ZZ8874-001/BMC_CMZY_080/DOCS/BQ_ADC_ANOMALY_INVESTIGATION_2026-11-09.md

# BQ76920 电压异常读数调查（2026-11-09）

> **历史调查（已被 2026-11-10 降级方案取代）**：当前固件不再尝试恢复/信任真实 VC5/BAT；cell3 取 cell1/cell2 均值、pack 取三节和，raw VC5/VC3/VC4/BAT 仅作诊断。本文的 partial/降级归档/9 帧/锁存建议不再适用，仅保留为故障现象记录。

范围：只调查 `dbglog/` 中 2026-11-08/09 的 Ozone 导出、当前固件读数链路和 `DOCS/bq769X0.pdf`；未改固件，未做上板测量。**用户已确认焊接正常**；下文不把接线错误当成既定原因。所有 CSV 是 Ozone `Level,Expression,Value,Location,Refresh` **单次监视变量快照，不是逐帧时间序列**；同一快照内 1 Hz/5 Hz 轮询的变量也不一定同时采集。文件名中的操作描述不是独立测量证据。

## 可确认的现象

| 导出文件 | 当时记录 | 能确认什么 |
| --- | --- | --- |
| `Ozone_Watched_Data_1_261108复位后.csv` | `now_ms=1921`，`raw_vc3=5264`、`raw_vc4=6867`、`raw_pack=11691`，`last_reject_pack_mv=17802`；`frame_ok_count=0`、`reject_cell_count=5`，`sys_stat=0x8C`；配置及 ADC-off 回读正常，`xready_count=0`（行 30–33、60–82、88–103、118–142）。 | 开机后的异常不是单纯“未等到第一帧”：已有多次**完整帧**被电压范围校验拒绝。VC3/VC4 是 3S 应短接的未用差分通道，原始码本应接近零。 |
| `Ozone_Watched_Data_1_261108第一次重试后第二次重试前.csv` | 与上条同 `uptime_base_s=31632555`、LP seq=41；`now_ms=3570`，`raw_vc3=995`、`raw_vc4=1355`，`last_reject_pack_mv=12571`；`adc_restart_count=1`、`frame_ok_count=0`、`reject_sum_count=4`（行 30–33、73–103、132–149、268）。 | 同基准/seq、递增的启动毫秒数**支持**这是同次启动的后一张快照；仍非连续记录，不能完全排除中间又复位。两张快照间异常幅度减小，但尚未成功发布，不足以证明 ADC 重启是根因或最终恢复手段。 |
| `Ozone_Watched_Data_1_261108红灯快闪OK不涨.csv` | `now_ms=40031`，`raw_vc3=1589`、`raw_vc4=3018`，最近被拒 BAT 为 14833 mV；79 次拒绝（77 次 CELL_RANGE），`oor_streak=66`，两次重启额度用完、`adc_recovery_failed=1`，`last_update_ms=1299`（行 30–33、58–103、113–143）。 | 该回合异常**持续数十秒**且曾有少数好帧；不能只用 250–300 ms 的首次 ADC 建立时间解释。`HAL_I2C` 此刻 `State=READY,ErrorCode=0`（行 13–16），但它不是累计总线错误计数。 |
| `Ozone_Watched_Data_1_261108_红灯时ok帧增长阶段.csv` → `...红灯时ok帧增长阶段后状态正常.csv` | 两次快照共享 `uptime_base_s=31632453`、LP seq=18，`now_ms=52754→79990`，`frame_ok_count=97→151`、拒绝数始终 14；VC3/VC4 `0/7→7/8`，`fresh=1`（各文件行 30–33、58–89、149、204）。 | **同一回合**此时已经持续正常发布。它们与上条红灯/OK 不涨快照的 `uptime_base_s=31632461`、LP seq=23 不同，不能拼成“那次坏读数在未复位情况下恢复”的直接证据。 |
| `Ozone_Watched_Data_1_261109.csv` | 三节原始码 `9881/9881/9937`，VC3/VC4 `224/9`，BAT 原始码 `7483`；最近被拒三节 `3777/3777/3798` mV、BAT `11440` mV，原因 `VC34_SANITY`，`reject_vc34_count=3`（行 57–97）。 | 细小但可复现的未用通道异常会使一帧不发布，**即使三节电压约 3.8 V 且总压看起来合理**。该导出包含较新的结构体字段，不能据此认定其固件与 11/08 所有导出完全相同。 |

`Ozone_Watched_Data_1_261108复位完外加两次尝试失败后闪红灯前这次闪红灯后ok开始涨.csv` 的 `Value` 列全为空，**不能**用文件名验证“失败后自动恢复”。其余 `261108` 导出也不是同一程序版本/启动的连续曲线；对比前应核对 MCU `uptime_base_s`、LP session seq、固件镜像和 `now_ms`。

### 关键数值关系

在 11/09 快照中，当前读数的 `(9881+9881+9937+224+9)/4 = 7483`，**正好等于该次快照的 BAT 原始码**。另以**最近一次被拒帧**的 `last_reject_*` 比较：BAT 与三节之和相差 `11440−(3777+3777+3798)=88 mV`，同帧 VC3+VC4 的 `233` 个原始码乘 `(365+13) µV/码` 约为 `88.1 mV`。11/08 `Ozone_Watched_Data_1_261108.csv` 的最近被拒帧还显示约 `69 mV` 的 BAT−三节差（行 88–96），与 VC3 原始码 184 对应的约 `70 mV` 相近。TI 数据手册 §8.3.1.1.6（印刷页 21）说明 BAT 来自单节测量值之和除以四；这些数字支持异常 VC3/VC4 报告值与 BAT 偏高有关，但由于快照采集时序和跨寄存器更新边界，不能把它当作每一帧都严格满足的恒等式。当前固件仅把 VC1、VC2、VC5 当作三节（`App/bsp/bq_ic.c:123-134,483-516,959-985`）。

**结论强度：**观测强烈支持“BQ 报出的未用 VC3/VC4 差分码异常，并影响 BAT；校验层据此拒绝帧”。它**不能**单独判明异常发生在 IC 引脚实际差分电位、芯片模拟前端/采样时序，还是寄存器读取路径。数伏级坏帧还伴有 CELL_RANGE，不能声称仅靠 VC3/VC4 就解释了全部异常；部分 11/08 导出未展开三节被拒数组，无法对其做同一帧的完整总和校验。

## 固件行为与候选机制（按现有证据排序）

1. **优先排查 BQ 差分输入/芯片内部采样在启动及运行中的异常。** TI `DOCS/bq769X0.pdf` Table 9-2（印刷页 39）要求 3S 为 VC1−VC0、VC2−VC1、VC5−VC4，VC3−VC2 和 VC4−VC3 短接；`DOCS/PINMAP.md:157-174` 记载本板已做 3S 飞线。数字 VC3/VC4 很大与此不符，但不能仅凭 Ozone 码值否定已确认的焊接。TI §8.3.1.1.2（印刷页 17–18）说明单通道约 50 ms、整组约 250 ms，明确的“等待 250 ms”针对 **SHIP→NORMAL**；并未保证已在 NORMAL 的 `ADC_EN` 关开后 300 ms 必然稳定。反过来，持续约 40 s 的异常也不是普通的一个 250 ms 帧没等完。不能把 100 Ω ×100 nF 的常规滤波单独当成数秒/数伏现象的已证原因。决定性证据是异常**同时**测得 BQ 芯片脚 VC3−VC2、VC4−VC3 是否真有差分电压，并同步看 REGSRC、REGOUT、BAT、TS1。
2. **旧版恢复判决可能过早耗尽额度，但不制造原始坏码。** 11/08 对应提交中的 OOR 重采样/ADC-off 保持/verdict 分别为 `300/300/500 ms`；当前**未提交** `App/bsp/bq_ic.c:83-92` 为 `500/800/1500 ms`。首次有效发布还要两帧一致（`bq_ic.c:959-1090`），短 500 ms verdict 有机会先判失败并耗尽两次额度；旧日志中两次重启后仍数十秒有坏原始码，说明**只调大超时并不能证明消除物理/AFE 侧异常**。故障锁存后常规 RUN 读取仍继续；连续四个成功发布帧会清 `ADC_STUCK`/重启额度（`bq_ic.c:795-929`）。红灯可由保护锁存、自检状态等独立维持，不等于“ADC 此刻还没读到正常值”。
3. **I²C 边沿/CRC 及非原子采样是需要排除的次要因素。** 驱动分寄存器读 VC1/2/5、VC3/4 和 BAT，逐字节校验 CRC；通信失败走重试/回退路径，电压越界才走拒帧（`bq_ic.c:123-134,1480-1659,707-863`）。本板仅 MCU 内部上拉（`DOCS/PINMAP.md:47-49`），应测 SCL/SDA 上升沿和高电平时间；但 11/09 **同一快照的五通道/BAT 精确关系**不支持“随机 I²C 位翻转是唯一原因”。多次寄存器读取可跨 250 ms 芯片更新边界，须用同一 `last_reject_*` 帧而非不同时刻的 `raw_*`/已发布 `cell_mv` 硬算残差。`pack_residual_mv` 在拒帧时是上次**发布**帧的值。
4. **状态/告警是伴随现象，暂不宜定因。** 11/08 快照中有 OV/UV 锁存；11/09 的 `SYS_STAT=0x94` 含 CC_READY、OV、OVRD_ALERT，`xready_count=0`（`261109.csv:43,114-125`）。状态位不等于异常采样的触发原因。MCU 复位不一定让 BQ POR：`BQ_Init` 若仍能探测到芯片会跳过 TS1 唤醒脉冲（`bq_ic.c:1797-1818`）；比较 MCU 复位、LP 出入及真正上电后的症状，但不要凭 LED 颜色倒推 ADC 原因。

## 补充现场观察：故障时第三节显示「7 V 满值」

用户补充：**每次故障时第三节电池电压均显示为 7 V 满值**。这条现场观察比现有 CSV 的缺失字段更能缩小范围：应优先检查 **CELL3 对应的 VC5−VC4 差分通道及其读回过程**，而不能只把 VC3/VC4 的非零码当成主因。此前的数伏级坏帧记录未展开 `raw_cell[2]` 和 `last_reject_cell_mv[2]`；仅凭这些 CSV 不能独立验证“无一例外”或确认精确的满值码。11/09 导出中展开的第三节原始码为 9937，最近一次被拒帧的第三节为 3798 mV，**并非 7 V**（`dbglog/Ozone_Watched_Data_1_261109.csv:57-60,88-96`），所以也不能把该次小幅 VC3/VC4 异常直接等同于用户描述的“第三节满值”故障。应在下一次典型故障时将 `raw_cell[2]`、`last_reject_cell_mv[2]` 连同 `raw_vc3/raw_vc4/raw_pack` 展开，记录带单位的显示来源。

**「7 V」需要先辨明是哪个变量/界面的值。** TI 数据手册 §8.3.1.1.2（印刷页 17）给 14 位单节 ADC 的标称满量程约 6.275 V。当前驱动在 `App/bsp/bq_ic.c:48,626-631,483-495` 对 VC5 原始值掩码 `0x3FFF`，并按 `GAIN×raw+OFFSET` 换算；日志中的 `GAIN=(365+13) µV/码`、`OFFSET=42 mV` 对应理论可计算最大约 **6.235 V**（整数实现为 6234 mV）。**7.000 V 需原始码至少 18408，超过 14 位最大 16383**；即使用驱动可解析的最大增益 396 µV/码、最大正偏移 127 mV，计算结果也不超过 6614 mV。固件又在 `bq_ic.c:712-716` 拒绝超过 5 V 的单节值，因此 `s_bq.cell_mv[2]`（上次成功发布值）不应等于 7000 mV。如果观察到的是某个上位机/Ozone 自定义换算、其他变量、界面显示钳位或近似口述的“7 V”，须与 `s_bq.raw_cell[2]`、`last_reject_cell_mv[2]` 对齐再判断；**不能把 7.000 V 直接称为当前驱动读到的 BQ 精确满量程值**。

若坏帧的 `raw_cell[2]` 确实反复接近 `0x3FFF`、而同时间外接测量 VC5−VC4 仍在正常 3–4 V，则“第三节真实过压”与单纯 mV 换算错误都弱，需重点区分 BQ 内部该通道饱和/采样异常、VC5/VC4 引脚电位瞬态、读寄存器地址/数据关联错误。若 `raw_cell[2]` 不饱和，但外部显示恒为 7 V，先追查该显示项的来源和换算。**一个待验证的外部显示假设**：若显示端用 `BAT−CELL1−CELL2` 反推第三节，11/08 红灯快闪快照的最近被拒 BAT 为 14833 mV，而此前发布的电芯电压约 3.8–3.9 V/节，则混用这些值可得到约 7 V；但它们**不是同一坏帧**，不能拿这个算式证明现场显示来源，也不能据此判定 VC5 饱和。当前固件直接读取 VC5 作为第三节（`App/bsp/bq_ic.h:29-39`），不以 BAT 减前两节。下一次应记录显示项的实际变量/表达式，并用同一坏帧的 `last_reject_cell_mv[0..2]` 和 `last_reject_pack_mv` 核算。VC3/VC4 异常可能与 VC5−VC4 共因，**不能由一个次要通道症状推断 VC5 饱和的根因**。

## 不改固件的最小验证顺序

1. 固定**同一个固件镜像和同一次 MCU boot**，在 Ozone 展开 `s_bq.last_reject_cell_mv[0..2]`、`last_reject_pack_mv`、`last_reject_vc3_raw/vc4_raw`、`raw_cell[0..2]`、`raw_pack`、`adc_gain/offset`、`frame_ok_count/frame_reject_count/reject_*_count`、`adc_restart_*`、`pre/post/adc_off_ctrl*`、`sys_stat`、`s_app.uptime_base_s`、LP session seq；在出现异常到恢复期间连续导出/记录带主机时间戳的数据。不要把不同 boot 的导出串成一条曲线，也不要用调试器暂停后的时长当真实 ADC 建立时间。
2. 在不拆线/不解除保护的前提下，用合适的高阻差分探头**优先同步测 BQ IC 引脚 VC5−VC4（第三节）**，并记录其对应 `raw_cell[2]`/`last_reject_cell_mv[2]`；再测 VC3−VC2、VC4−VC3，与数字 VC3/VC4 码对应：第三节引脚正常而码饱和 → 优先查 IC 内部采样、供电/复位时序及读寄存器链路；引脚确实出现差分瞬态 → 排查滤波网络与供电耦合（**不等于焊接坏**）。同时看 BAT、REGSRC、REGOUT、TS1、ALERT，注意示波器接地不要短接电池节点。
3. 针对正常运行/复位/LP 唤醒分别比较 ADC 启动后的约 50、250、500、1000 ms 及**异常持续数十秒**时的同帧 VC1–VC5/BAT 和状态；若改为当前 500/800/1500 ms 版本后复现率变化，记录镜像与上电/MCU 复位条件，以区分“启动窗口过短”和“持续异常”。另测 SCL/SDA 实际波形，核对 TI §7.6（印刷页 14）的 100 kHz、`tHIGH≥4 µs` 要求。

调查结论暂定为**「第三节显示异常满值（现场观察），并伴随 BQ 报告的 VC3/VC4 差分通道读数异常（快照已证）；VC5 原始码是否饱和，以及芯片输入端实际电位与内部采样/读寄存器之间尚缺同步证据」**，不是已经确诊了某个软件或硬件元件。待上述同帧数据和芯片脚波形齐全后再收敛原因。
