ZZ8874-001/BMC_CMZY_080/DOCS/SCH_SCHEM_BTT_CTRL_081_2026-10-30.pdf

# CAN SWD_PORT

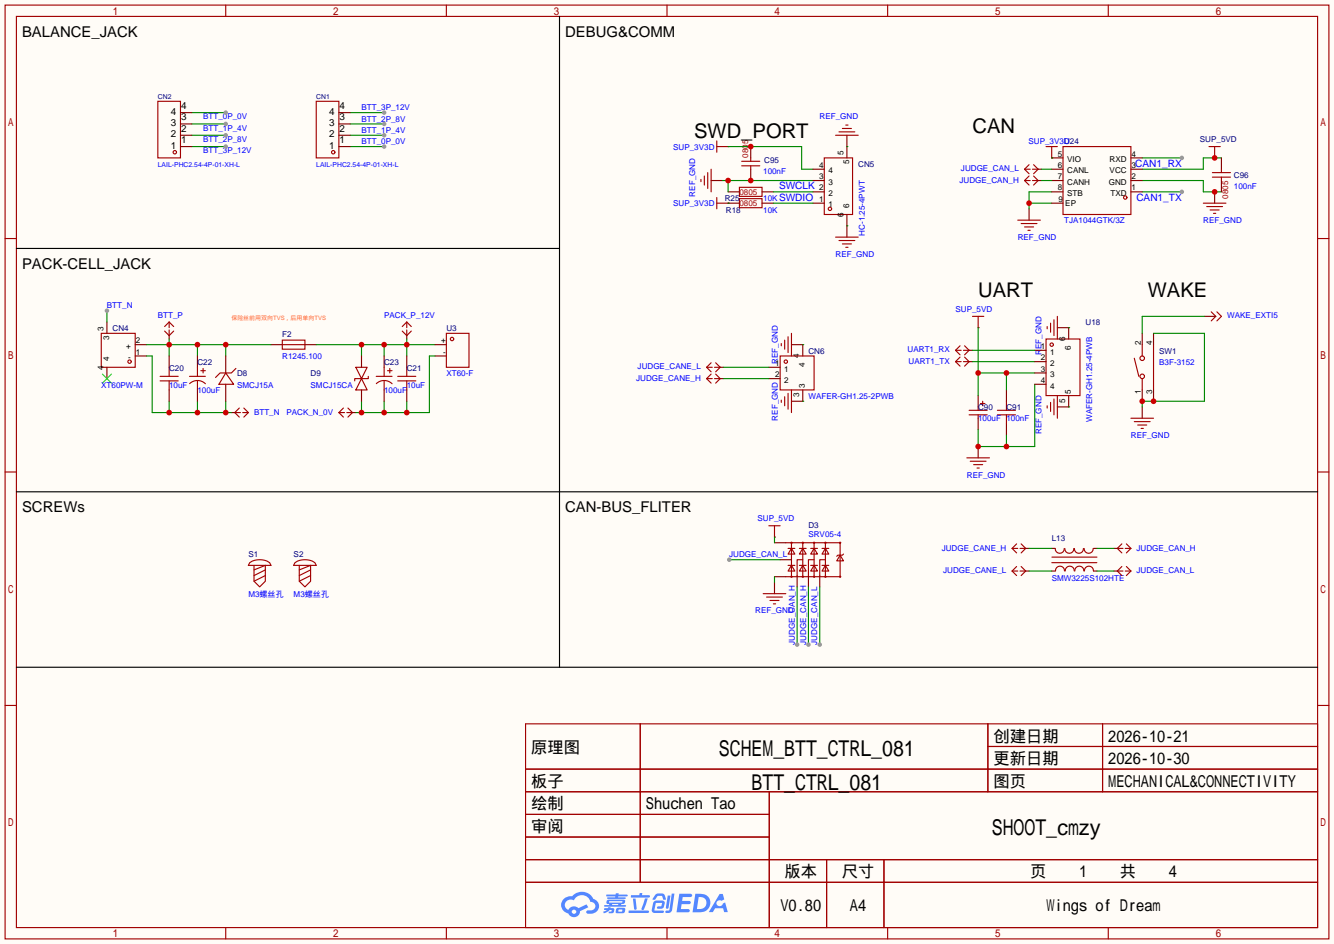
[picture p1: page 1]

原理图 | SCHEM_BTT_CTRL_081 | 创建日期 | 2026-10-21

更新日期 | 2026-10-30

板子 | BTT_CTRL_081 | 图页 | MECHANICAL&CONNECTIVITY
绘制 | Shuchen Tao | SHOOT_cmzy
审阅

V0.80 | A4 | Wings of Dream

# BMS

PWRSUP_RC | SC_TEMP&BOOT

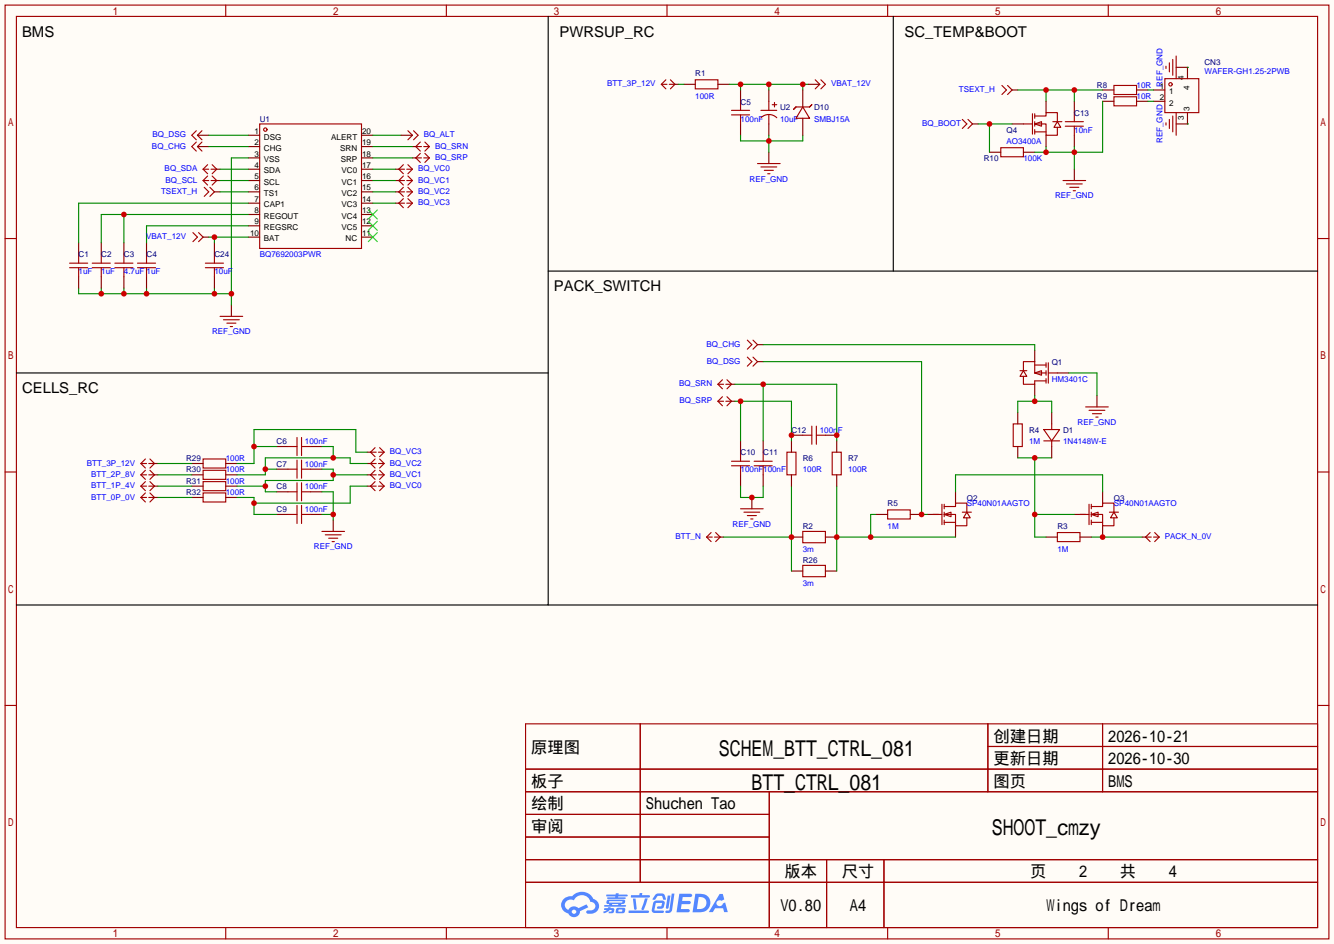
[picture p2: page 2]

原理图 | SCHEM_BTT_CTRL_081 | 创建日期 | 2026-10-21

更新日期 | 2026-10-30

板子 | BTT_CTRL_081 | 图页 | BMS
绘制 | Shuchen Tao | SHOOT_cmzy
审阅

PWR_5VD | PWR_LP3V3D | POTENTIAL

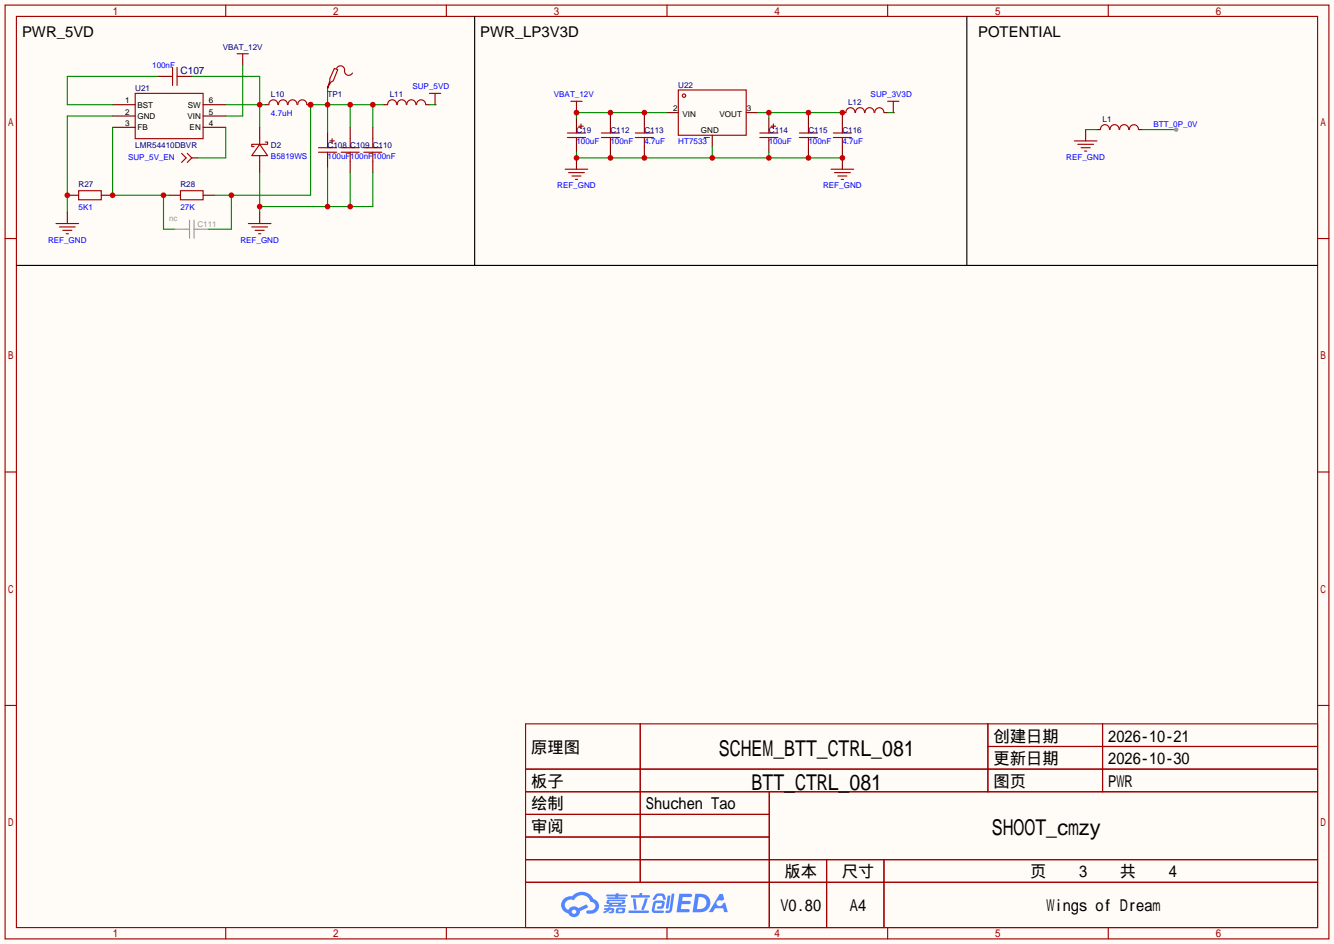
[picture p3: page 3]

原理图 | SCHEM_BTT_CTRL_081 | 创建日期 | 2026-10-21

更新日期 | 2026-10-30

板子 | BTT_CTRL_081 | 图页 | PWR
绘制 | Shuchen Tao | SHOOT_cmzy
审阅

# OSC1 12MHz REF_GND

MCU_MAIN | LEDs_IND

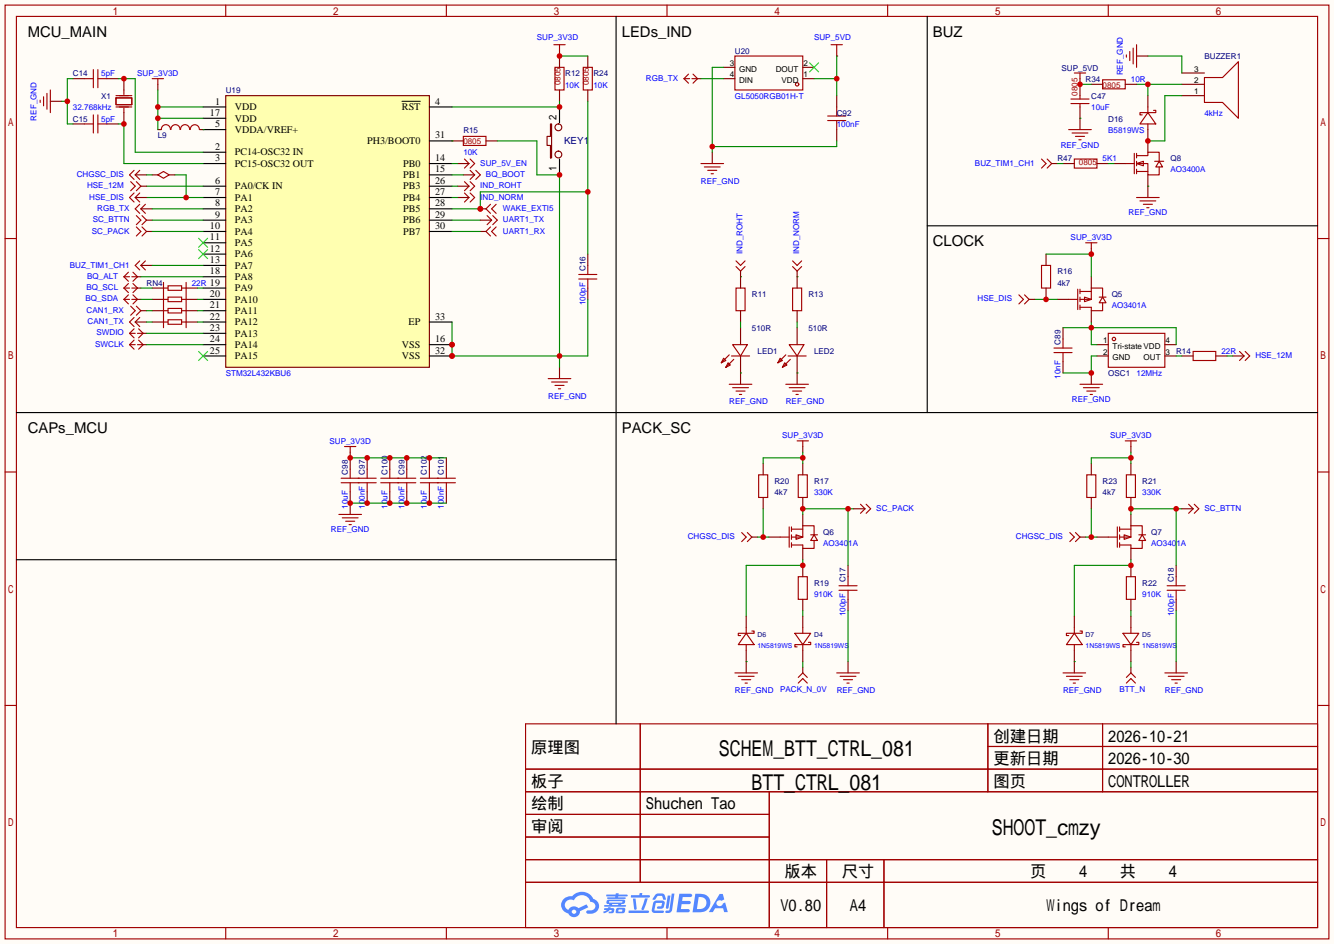
[picture p4: page 4]

原理图 | SCHEM_BTT_CTRL_081 | 创建日期 | 2026-10-21

更新日期 | 2026-10-30

板子 | BTT_CTRL_081 | 图页 | CONTROLLER
绘制 | Shuchen Tao | SHOOT_cmzy
审阅
