ZZ8874-001/BMC_CMZY_080/BMC_CMZY_080.ioc

Mcu.UserName=STM32L432KBUx
PA0.Signal=RCC_CK_IN
PA1.GPIO_Label=HSE_DIS
PA1.Signal=GPIO_Output
PA10.GPIO_Label=BQ_IIC1_SDA
PA10.Signal=I2C1_SDA
PA11.Signal=CAN1_RX
PA12.Signal=CAN1_TX
PA2.GPIO_Label=RGB_USART2_TX
PA2.Signal=USART2_TX
PA3.GPIO_Label=COMP_BTTN
PA3.Signal=COMP2_INP
PA4.GPIO_Label=COMP_PACK
PA4.Signal=COMP2_INM
PA7.GPIO_Label=BUZ_TIM1_CH1
PA7.Signal=TIM1_CH1N
PA8.GPIO_Label=BQ_ALT_EXTI8
PA8.Signal=GPXTI8
PA9.GPIO_Label=BQ_IIC1_SCL
PA9.Signal=I2C1_SCL
PB0.GPIO_Label=SUP_5V_EN
PB0.Signal=GPIO_Output
PB1.GPIO_Label=BQ_BOOT
PB1.Signal=GPIO_Output
PB5.GPIO_Label=WAKE_EXTI5
PB5.Signal=GPIO_Input
PB6.Signal=USART1_TX
PB7.Signal=USART1_RX
