ZZ8874-001/BMC_CMZY_080/Core/Src/main.c

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
/* Includes ------------------------------------------------------------------*/
#include "main.h"

/* USER CODE BEGIN Includes */
#include "app/main_app.h"
#include "app/watchdog.h"
/* USER CODE END Includes */

CAN_HandleTypeDef hcan1;

COMP_HandleTypeDef hcomp2;

DAC_HandleTypeDef hdac1;

I2C_HandleTypeDef hi2c1;
DMA_HandleTypeDef hdma_i2c1_rx;
DMA_HandleTypeDef hdma_i2c1_tx;

IWDG_HandleTypeDef hiwdg;

LPTIM_HandleTypeDef hlptim1;

RTC_HandleTypeDef hrtc;

TIM_HandleTypeDef htim1;
TIM_HandleTypeDef htim2;

UART_HandleTypeDef huart1;
UART_HandleTypeDef huart2;

void SystemClock_Config(void);
static void MX_GPIO_Init(void);
static void MX_DMA_Init(void);
static void MX_CAN1_Init(void);
static void MX_COMP2_Init(void);
static void MX_DAC1_Init(void);
static void MX_I2C1_Init(void);
static void MX_USART1_UART_Init(void);
static void MX_USART2_UART_Init(void);
static void MX_TIM1_Init(void);
static void MX_RTC_Init(void);
static void MX_TIM2_Init(void);
static void MX_LPTIM1_Init(void);
static void MX_IWDG_Init(void);
/**
  * @brief  The application entry point.
  * @retval int
  */
int main(void)
{

  /* MCU Configuration--------------------------------------------------------*/

  /* Reset of all peripherals, Initializes the Flash interface and the Systick. */
  HAL_Init();

  /* USER CODE BEGIN Init */
  /* Defensive legacy LSE-CSS cleanup.  Current IOC has EnableCSSLSE=false and
   * the firmware never enables it; an old build may have left LSECSSON/D set
   * in the backup domain.  Clear it before the RTC source helper runs so a
   * dead LSE cannot hold boot.  A BDRST here clears BKP (LP session) once. */
  __HAL_RCC_PWR_CLK_ENABLE();
  HAL_PWR_EnableBkUpAccess();
  if ((RCC->BDCR & (RCC_BDCR_LSECSSON | RCC_BDCR_LSECSSD)) != 0u)
  {
      SET_BIT(RCC->BDCR, RCC_BDCR_BDRST);
      CLEAR_BIT(RCC->BDCR, RCC_BDCR_BDRST);
  }
  /* USER CODE END Init */

  /* Configure the system clock */
  SystemClock_Config();

  /* USER CODE BEGIN SysInit */
  /* Keep LSE CSS off; the current IOC does not enable it.  LSERDY is only a
   * diagnostic in LP_RTC_USE_LSE=1 builds (PowerMode_LseHealthTask()). */
  CLEAR_BIT(RCC->BDCR, RCC_BDCR_LSECSSON);
  /* USER CODE END SysInit */

  /* Initialize all configured peripherals */
  MX_GPIO_Init();
  MX_DMA_Init();
  MX_CAN1_Init();
  MX_COMP2_Init();
  MX_DAC1_Init();
  MX_I2C1_Init();
  MX_USART1_UART_Init();
  MX_USART2_UART_Init();
  MX_TIM1_Init();
  MX_RTC_Init();
  MX_TIM2_Init();
  MX_LPTIM1_Init();
  MX_IWDG_Init();
  /* USER CODE BEGIN 2 */
  App_Boot();
  /* USER CODE END 2 */

  /* Infinite loop */
  /* USER CODE BEGIN WHILE */
  while (1)
  {
    /* USER CODE END WHILE */

    /* USER CODE BEGIN 3 */
    App_Loop();
  }
  /* USER CODE END 3 */
}

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
