ZZ8874-001/BMC_CMZY_080/App/detect/bms/bms_config.h

/*********************************************************************************
 * File Name          : bms_config.h
 * Description        : 电池 SOC / SOH 算法库 —— 唯一配置入口
 *
 * 算法库的全部可调参数都集中在本文件, 一共 10 组:
 *   [1] 电芯参数     换电芯只改这一组 (标称容量 + 容量可用范围 + 4 张标定表)
 *   [2] 调度与时基   主循环调用周期 / 时间戳跳变保护
 *   [3] 静置判据     静置电流门限 + 静置时长 (SOC 重同步 / SOH 锚点)
 *   [4] EKF 参数     一阶 RC 扩展卡尔曼: 过程噪声 / 量测噪声 / 初值
 *   [5] SOH 判据     R0 学习 (电流阶跃) + Q 学习 (OCV 锚点) + 卡尔曼融合
 *   [6] 钳位与防呆   容量范围 / R0 表存储范围 / SOH_R 统计网格
 *   [7] 移植开关     时间戳来源 / exp 来源
 *   [8] 掉电保持     学习结果存非易失介质 / 落盘去抖 / 介质选型
 *   [9] 在线调参     运行时通过串口改标定表与参数的协议层开关
 *   [10] 温度/倍率/循环 容量与 SOC 的工况折算 + 循环计数与累计充放电
 * 每组标题下都写了"什么时候需要改 / 改了会怎样"。
 * 文件末尾还有一节"编译期一致性自检": 整数类参数改冲突了会直接编译报错。
 *
 * ---------------------------------------------------------------------
 * 调参速查 (想改什么 -> 改哪个宏):
 *   换电芯 / 换容量 .......... SOC_CAPACITY_NOMINAL_MAH + 4 张表       [1]
 *   主循环周期变了 .......... BMS_UPDATE_PERIOD_MS                    [2]
 *   静置多久才重同步 ........ SOC_IDLE_MS                             [3]
 *   静置多久才学容量 ........ SOH_MIN_REST_MS                         [3]
 *   静置电流门限 ............ SOC_IDLE_CUR_MA / SOH_IDLE_MA           [3]
 *   显示抖动大 / 跟不紧 ..... BMS_EKF_R_V / BMS_EKF_Q_SOC             [4]
 *   学不到容量 (不触发) ..... SOH_Q_MIN_DSOC_01 / SOH_Q_MIN_DQ_MAH    [5]
 *   容量学得太猛 / 上跳 ..... SOH_Q_KF_RUP / SOH_Q_KF_Q               [5]
 *   R0 学不动 / 学太乱 ...... SOH_I_ON_MA / SOH_R0_ALPHA              [5]
 *   温度窗口太窄/太宽 ....... SOH_TEMP_LO_C / SOH_TEMP_HI_C           [5]
 *   容量被钳得不对 .......... SOC_CAP_LO_PCT / SOC_CAP_HI_PCT         [6]
 *   没有毫秒时基 ............ BMS_USE_TICK                            [7]
 *   不想链接 libm ........... BMS_USE_LIBM_EXPF                       [7]
 *   SOH 学到的东西掉电就丢 .. BMS_USE_NVM                             [8]
 *   落盘太勤 (磨 Flash) ..... BMS_NVM_DEBOUNCE_MS                     [8]
 *   想用串口改标定表 ........ BMS_USE_TUNE                            [9]
 *   调参缓冲太大 (省 RAM) ... BMS_TUNE_RX_MAX                         [9]
 *   低温/大倍率容量折算 ...... SOC_CAP_TEMP_PCT / SOC_PEUKERT_K       [10]
 *   循环计数阈值 ............ SOH_CYCLE_SWING_01 / SOH_COUNT_SAVE_PCT [10]
 *
 * 说明: 极少数参数 (0.01% 定点比例 10000 / 每 0.01% 的 mA·ms 换算系数
 * 360×容量 / 网格步长 10%) 属于算法定义而非可调量, 仍写在 soc.c / soh.c
 * 里; 改它们等于换算法, 不在本文件暴露。
 *
 * [5] 与 ../tools/soh_learn 顶部的常量一一对应, 改一处必须改两处!
 * (../tools/soh_mcu_sim 启动时会逐项比对并报警)
 *
 * 源码编码 UTF-8, 换行 LF。
 * 移植方法与调用顺序见同目录 README.md。
 *
 * 许可: MIT (见仓库根 LICENSE)。Copyright (c) 2026 锂电池 SOC/SOH 算法库 贡献者。
 *******************************************************************************/

#ifndef __BMS_CONFIG_H
#define __BMS_CONFIG_H

/* =====================================================================
 * [1] 电芯参数 —— 换电芯只改这一段
 * ===================================================================== */

/* 电芯标称容量 mAh。本板为 3S 三元锂（NMC）1500 mAh 电芯，单节容量填 1500；
 * 取标称值偏保守，使带载积分 SOC 略偏低不虚高。换电芯时按实际修改!
 *
 * 注意: 容量不是常量 —— soh.c 的在线学习会按实测改写运行时容量 s_cap_mah,
 * 本宏只是"上电初值 / 学习失败的兜底值 / SOH 的分母"。
 * 运行期一切积分与 EKF 都用 SOC_GetCapacityMAh() 取当前值。 */
#define SOC_CAPACITY_NOMINAL_MAH   1500

/* 容量可用范围 (占标称的百分比)。
 *
 * 运行时容量 (含学习结果) 被钳在这两个百分比之间, 挡单次离谱估计把 SOC
 * 算飞; 也顺带决定 SOH_Q 的下限 —— 容量学到 55% 标称, SOH_Q 就是 55%。
 *   下限 50  ->  0.50 倍标称 (低于此早已远超 EOL, 必是估计出错)
 *   上限 110 ->  1.10 倍标称 (新电芯实测略高于标称属正常散布)
 * 换到"标称值明显不准"的杂牌电芯时, 若实测容量落在范围外被钳住, 改这里。 */
#define SOC_CAP_LO_PCT             50
#define SOC_CAP_HI_PCT             110

/* =====================================================================
 * 温度维度
 *
 * 标定表不再是"一张", 而是"三个温度点各一张":
 *     BMS_CAL_TEMP_DC = { 5C, 25C, 45C }
 * 运行时按当前温度在相邻两点之间线性插值, 得到"当前温度的表"再用。
 * 温度低于最低点或高于最高点时端点平延 (不外推 —— 外推没有物理依据)。
 *
 * 注意: 本库随附的示例数据只有 25C 是实测的, 5C / 45C 直接复用 25C 的值
 *       占位 —— 三个点相同, 插值结果恒等于 25C 的值, 等价于"暂不随温度变"。
 *       换电芯后请把另外两个温度点补齐: 直接改下面的宏,
 *       或在运行时用 BMS_CAL_SetPoint() 写入 (见 README 多温度标定章节)。
 *
 * 插值只做线性: 三个点撑不起二次, 线性 + 端点平延是这种稀疏标定的
 * 合理选择 (Arrhenius 型关系在 5~45C 区间接近线性)。
 * ===================================================================== */

/* 温度点个数。改点数时必须同时改 BMS_CAL_TEMP_DC 和下面四张表的第一维,
 * bms_cal.c 里有编译期断言会拦住不一致 (数组长度算出来对不上就报错)。 */
#define BMS_CAL_TEMP_N             3u

/* 温度点 (0.1 摄氏度)。必须严格递增, 个数与下面各表的第一维一致。 */
#define BMS_CAL_TEMP_DC                             \
{                                                   \
    50,     /*  5 C */                              \
    250,    /* 25 C  常温, 唯一有实测数据的点 */      \
    450     /* 45 C */                              \
}

/* 温度变化时刷新标定表的阈值 (0.1 摄氏度)。
 * 太小 -> 温度抖动就重算一遍表 (浪费 CPU, 且频繁动 R0 基准);
 * 太大 -> 温度真变了却没跟上。20 = 2C: 电芯自热 + 环境温度变化都能跟上,
 * 而 NTC 的读数噪声 (约 ±0.3C) 触发不了。 */
#define BMS_CAL_TEMP_HYST_DC       20

/* 开路电压表:  SOC_OCV_TABLE_MV[ti][i] = 温度点 ti、SOC = i*10% 时的 OCV (mV)。
 *
 * 来源: PC 工具链 tools/soc_bench stair, 程控负载 2A 恒流放电 + 档间
 *       静置 483s, ΔOCV 等分 10 档, 实测 95% -> 9.1% 累计 2879mAh;
 *       以实测点分段线性插值到 10% 网格后回灌本表。
 * 各点说明 (改表时建议连同说明一起更新):
 *   0%    无实测: 沿用典型满放回弹值 3050 (10%~0% 段斜率 13.8mV/% 偏缓, 保守)
 *   10%   实测 ~9.9% 点 (静置 4.57τ 后取值)
 *   20~90% 实测。20~30% 段含未完全消退的极化, 比真值偏低 26~75mV
 *   100%  无满充实测: 由 95%~87% 段斜率 (+6.5mV/%) 外推得 4161
 *
 * 这是精度的天花板: 滤波只能把数字做稳, 不能做准。重标 OCV 表的方法见
 * ../tools/README (满充 4.20V CV->C/20, 0.2C 慢放到 2.8V)。 */
/* !!! 三元锂（NMC）1500 mAh 典型占位表（未标定）!!!
 * 曲线沿用原算法库的 NMC 3350 mAh 实测 OCV-SOC 数据 —— 同一化学体系、
 * 仅容量不同，作为 1500 mAh 三元电芯的典型静置曲线占位。NMC 平台区
 * 约 3.5~4.0 V，不能用 LFP 平台表；必须按实际电芯做 0.1C/0.2C 充放电
 * + 静置标定后替换。当前 SOC_EST_CAL_VALID=1 仅表示 SOC/SOH 可用于
 * 3.1 V 低电判断/显示；OCV/TAU 仍有占位成分，2.8 V 电压硬保护独立兜底，
 * 不得用 SOC 单独做 5%/0% 硬切断。 */

/* 原库 NMC 3350 mAh 25C 实测值本身 (唯一有数据的温度点)。不带外层大括号,
 * 便于下面三个温度点直接复用 —— 拿到本电芯 5C / 45C 实测后, 各自定义
 * 一行替换掉即可。 */
#define SOC_OCV_25C_MV                              \
    3050,   /*  0%  满放回弹典型（保守） */           \
    3188,   /* 10% */                                \
    3375,   /* 20% */                                \
    3524,   /* 30% */                                \
    3629,   /* 40% */                                \
    3748,   /* 50% */                                \
    3845,   /* 60% */                                \
    3938,   /* 70% */                                \
    4027,   /* 80% */                                \
    4096,   /* 90% */                                \
    4161    /* 100% 原库 NMC 外推值，标定后替换 */

#define SOC_OCV_TABLE_MV                            \
{                                                   \
    { SOC_OCV_25C_MV },   /*  5 C 待标定 (占位) */    \
    { SOC_OCV_25C_MV },   /* 25 C 原库 NMC 数据/本电芯占位 */ \
    { SOC_OCV_25C_MV }    /* 45 C 待标定 (占位) */    \
}

/* 欧姆内阻表: SOC_R0_TABLE_MOHM[i] = SOC = i*10% 时的 R0 (mΩ)。
 *
 * 本板 1500 mAh NMC 放电方向实测 (25C): 满电开始每放电 130 mAh 测一组,
 * 共 10 组。按 SOC_CAPACITY_NOMINAL_MAH=1500 换算, 实测点 SOC 为
 * 100/91.33/82.67/74.00/65.33/56.67/48.00/39.33/30.67/22.00%;
 * 线性插值到 10% 网格, 0~20% 用 22% 端点平延, 整数 mΩ 四舍五入。
 * 100% 实测 42.4 mΩ 低于 91.33% 的 51.42 mΩ, 保留原始趋势, 未做回归平滑。
 * 5C / 45C 仍复用 25C 占位, 待实测。
 *
 * 用途: EKF 量测方程 V_t = OCV - I*R0 - V_RC 的即时压降项; 也是
 * SOH_Init() 的 R0 基线/SOH_R 分母。R0 数据为放电方向, 充电方向共用
 * 同一出厂基线 (bms_cal 只有一张 R0 表), 充电方向的老化量由 SOH 单独学。
 *
 * 运行期可写 —— soh.c 的在线学习按电流阶跃 ΔV/ΔI 的实测值融合改写本表
 * (初值仍是这张标定表)。老化后 R0 整体抬高, 学习让 EKF 的即时压降项跟着走,
 * 否则带载端压预测会系统性偏高。
 * 注意: 本次只接入 R0/R1, OCV/TAU 仍是占位；SOC_EST_CAL_VALID=1 用于
 * 低电判断/显示，2.8 V 电压硬保护仍是独立兜底。 */
#define SOC_R0_25C_MOHM                             \
    41,     /*  0%  22% 以下端点平延 */               \
    41,     /* 10% */                                \
    41,     /* 20% */                                \
    43,     /* 30% */                                \
    44,     /* 40% */                                \
    46,     /* 50% */                                \
    45,     /* 60% */                                \
    46,     /* 70% */                                \
    47,     /* 80% */                                \
    51,     /* 90% */                                \
    42      /* 100% 满电实测 42.4 mΩ */

#define SOC_R0_TABLE_MOHM                           \
{                                                   \
    { SOC_R0_25C_MOHM },   /*  5 C 待标定 */          \
    { SOC_R0_25C_MOHM },   /* 25 C 实测 */            \
    { SOC_R0_25C_MOHM }    /* 45 C 待标定 */          \
}

/* 极化电阻表: SOC_R1_TABLE_MOHM[i] = SOC = i*10% 时的 R1 (mΩ)。
 *
 * 同一组 1500 mAh NMC 放电实测 (25C) 的 R1 列: 实测 SOC 点与 R0 相同,
 * 线性插值到 10% 网格, 0~20% 用 22% 端点平延, 整数 mΩ 四舍五入。
 * 5C / 45C 仍复用 25C 占位, 待实测。
 * 用途: EKF 的 RC 状态递推 vrc' = a*vrc + I*R1/1000*(1-a)。 */
#define SOC_R1_25C_MOHM                             \
    45,     /*  0%  22% 以下端点平延 */               \
    45,     /* 10% */                                \
    45,     /* 20% */                                \
    46,     /* 30% */                                \
    49,     /* 40% */                                \
    51,     /* 50% */                                \
    52,     /* 60% */                                \
    52,     /* 70% */                                \
    54,     /* 80% */                                \
    52,     /* 90% */                                \
    51      /* 100% 满电实测 51.3 mΩ */

#define SOC_R1_TABLE_MOHM                           \
{                                                   \
    { SOC_R1_25C_MOHM },   /*  5 C 待标定 */          \
    { SOC_R1_25C_MOHM },   /* 25 C 实测 */            \
    { SOC_R1_25C_MOHM }    /* 45 C 待标定 */          \
}

/* 极化时间常数表: SOC_TAU_TABLE_S[i] = SOC = i*10% 时的 τ (秒)。
 * 原库 NMC 3350 mAh 的静置回弹 ln 斜率 (动态带 10%~98%)。真实电池多阶,
 * 此表是"主极化"等效单阶 τ, EKF 用它做 RC 状态递推的衰减系数
 * a = exp(-dt/τ)。平台区 (30~70%) τ ≈ 100~125s; 低端 (9~20%) 36~109s 递减。
 *
 * 本板 1500 mAh NMC 的 R0/R1 已接入本文件前面的实测表; 对应的 tau 测量值
 * 为 83~138 ms, 但本表单位是秒且 EKF 步长为 500 ms, 单位/采样周期尚未对齐,
 * 本次保持原库占位值不变, 待确认 tau 单位与算法时基后再单独标定。
 *
 * 本表的 τ_max 决定 [3] 里两个静置时长该取多大 (经验: 静置时长 ≈ 5~8 倍 τ_max),
 * 换电芯后重标此表, 记得回头核对 SOC_IDLE_MS / SOH_MIN_REST_MS。 */
#define SOC_TAU_25C_S                               \
    36,     /*  0% */                                \
    44,     /* 10% */                                \
    109,    /* 20% */                                \
    99,     /* 30% */                                \
    117,    /* 40% */                                \
    125,    /* 50% */                                \
    109,    /* 60% */                                \
    83,     /* 70% */                                \
    78,     /* 80% */                                \
    71,     /* 90% */                                \
    70      /* 100% */

#define SOC_TAU_TABLE_S                             \
{                                                   \
    { SOC_TAU_25C_S },   /*  5 C 待标定 */            \
    { SOC_TAU_25C_S },   /* 25 C 实测 */              \
    { SOC_TAU_25C_S }    /* 45 C 待标定 */            \
}

/* =====================================================================
 * [2] 调度与时基
 * ===================================================================== */

/* 主循环调用 SOC_AhUpdate() / SOH_Update() 的名义间隔 (ms)。
 *
 * 改成别的周期时, 本文件里这些"按帧数"定义的参数要一起换算:
 *   SOC_QUIET_DEBOUNCE / SOH_IDLE_DEBOUNCE  ≈ 1000 / 周期  (约 1s 消抖)
 *   SOH_R0_TAIL_N                           ≈ 1000 / 周期  (约 1s 的末段均值)
 * EKF 的步长 dt 直接取本宏换算, 自动跟随, 不需要另改。
 * 安时积分用的是真实时间戳差 (BMS_NowMs), 与本宏无关 —— 本宏只决定
 * "拿不到时间戳时的兜底 dt" 和 "EKF 的标称步长"。 */
#define BMS_UPDATE_PERIOD_MS       500

/* 单帧时间戳跳变保护: 相邻两帧的时间戳差超过本值, 视为异常帧
 * (复位 / 长时间阻塞 / 调试断点), 积分与计时用 BMS_UPDATE_PERIOD_MS 兜底。
 * 设得比正常帧间隔大一个量级以上即可; 太小会误判正常的偶发丢帧。 */
#define BMS_DT_MAX_MS              2000

/* =====================================================================
 * [3] 静置判据 —— "什么时候算静置" + "静置多久才动作"
 *
 * 这里有两条独立的时间线, 服务两个不同目的, 不要混:
 *   SOC_IDLE_MS      静置满 15min -> 用 OCV 查表校正安时积分基准 (纠漂移)
 *   SOH_MIN_REST_MS  静置满 10min -> 记一个 OCV 锚点, 攒够跨度学容量
 * 两者都要求极化电压基本消掉读数才准, 而极化时间常数 τ 见 SOC_TAU_TABLE_S
 * (平台区最大 125s), 所以经验关系是:
 *   SOC_IDLE_MS      ≈ 6~8 倍 τ_max   (900s / 125s = 7.2)
 *   SOH_MIN_REST_MS  ≈ 4~5 倍 τ_max   (600s / 125s = 4.8)
 * 换电芯后若 τ 表变化明显, 按同样的倍数关系重新取这两个值。
 * 取小了: OCV 读数还带极化, 会把 SOC 基准/容量学歪 (系统性误差)。
 * 取大了: 只是变慢, 不会算错。
 * ===================================================================== */

/* 静置电流门限 (mA): |I| 小于本值视为"静置"。
 * 取值依据: 参考板上用的电流采样芯片在静置时实测噪声约 ±19mA, 20mA 卡在
 * 噪声上沿。换成噪声更大 (或更小) 的电流计必须按实测噪声重取本值 ——
 * 取小了静置检测永远不通过, 取大了小电流工况会被误判成静置。 */
#define SOC_IDLE_CUR_MA        20       /* soc.c 用 */
#define SOH_IDLE_MA            20       /* soh.c 用 (两者保持同值) */

/* 静置消抖帧数: 连续 N 帧 |I| 低于门限才算真的进入静置态 (~N × 周期)。
 * 目的: (a) 挡住单帧电流毛刺重置静置计时器;
 *       (b) 静置态下本帧跳过安时积分, 堵住上述电流噪声被当小电流累计的漂移。
 * 必须 >= 1 帧; 5 帧 = 1s, 与人工"电流稳定 1 秒以上"的经验一致。 */
#define SOC_QUIET_DEBOUNCE     2        /* soc.c: ~1s @500ms */
#define SOH_IDLE_DEBOUNCE      2        /* soh.c: ~1s @500ms (两者保持同值) */

/* SOC: OCV 重同步所需的连续静置时长 (ms), 900000u = 900s = 15min。
 * 达到后向 OCV 查表值平滑校正积分基准 (首次直接覆盖, 之后半衰收敛)。 */
#define SOC_IDLE_MS            900000u

/* SOC: 每次重同步最多修正多少 (0.01% 单位, 200 = 2%)。
 * 只对"非首次"重同步生效 (首次是直接覆盖)。调大 -> 收敛快但显示会跳数字;
 * 调小 -> 显示平滑但大偏差要多次静置才逼近。 */
#define SOC_RESYNC_MAX_01      200

/* SOH: 记一个 OCV 锚点所需的连续静置时长 (ms), 600000u = 600s = 10min。
 * 这个锚点只负责"记下当时的 SOC 与已放出电荷", 真正学容量要等两个锚点
 * 之间的跨度同时满足 SOH_Q_MIN_DSOC_01 与 SOH_Q_MIN_DQ_MAH。 */
#define SOH_MIN_REST_MS        600000u

/* =====================================================================
 * [4] EKF 参数 —— 一阶 RC 扩展卡尔曼 (端压平滑 + 极化观测 + SOC 微修)
 *
 * 状态 x = [soc(%), vrc(mV)]; 量测 = 端压
 *   soc' = soc - I*dt/(cap*3600)*100          (放电为正)
 *   vrc' = a*vrc + I*R1/1000*(1-a), a = exp(-dt/tau)
 *   h    = OCV(soc) - I*R0/1000 - vrc
 *
 * 全量调参结果 (49072 帧实测): q_soc=1e-3, q_vrc=0.5, R=10
 *   带载段 99.98% 单调下降, 各静置末与安时积分参考 RMS 偏差 0.72%
 *
 * 怎么改 (调一个, 另一个不动):
 *   Q 调小 = 更信积分/模型 -> 显示更平滑, 但对真实 SOC 变化的响应变慢
 *   Q 调大 = 更信当前数据 -> 响应快, 代价是电流噪声会传到 SOC 上
 *   R 调大 = 更信模型 -> 端压预测偏了也不怎么改 SOC (抗野值, 但跟不紧)
 *   R 调小 = 更信量测 -> SOC 跟端压跟得紧, 电流/电压噪声也更明显地传进来
 * 一般只在"电流采样噪声明显不同"的场景才动 R。
 * 换电芯体系 (LFP / 钠电, 电压平台极平) 时 Q/R 需要重新扫参。
 * ===================================================================== */

/* 过程噪声: 每帧 SOC 变化的不确定度 (%^2/帧) */
#define BMS_EKF_Q_SOC          0.001f
/* 过程噪声: 每帧极化电压变化的不确定度 (mV^2/帧) */
#define BMS_EKF_Q_VRC          0.5f
/* 量测噪声: 端压读数的不确定度 (mV^2), 与电流/电压 LSB 同量级 */
#define BMS_EKF_R_V            10.0f
/* 初值协方差 (仅上电 / 静置强同步 Reset 时用一次) */
#define BMS_EKF_P0_SOC         10.0f    /* SOC 初值不确定 ±3% */
#define BMS_EKF_P0_VRC         400.0f   /* vrc 初值不确定 ±20mV */

/* ---- 数值保护 (一般不需要改) ---- */
/* 新息 (量测残差) 绝对值超过本值就丢弃该帧量测 (mV)。
 * 挡的是接触弹跳 / 电流计校准尖峰这类野值, 不是正常极化。 */
#define BMS_EKF_RES_MAX_MV     250.0f
/* 新息方差下限, 防除零 (mV^2) */
#define BMS_EKF_S_MIN          1e-6f
/* 协方差下限: 防协方差被压到 0 后卡尔曼增益永久为 0 (滤波器卡死) */
#define BMS_EKF_P_MIN          1e-4f

/* =====================================================================
 * [5] SOH 判据
 *   与 ../tools/soh_learn 顶部常量一一对应, 改一处必须改两处!
 *   (../tools/soh_mcu_sim 启动时会做逐项比对并报警)
 * ===================================================================== */

/* ---- R0 学习 (电流阶跃事件触发) ----
 * 状态机: 静置 --|I|>SOH_I_ON_MA--> 带载 --|I|<SOH_I_OFF_MA--> 断电首帧
 *         -> 次帧确认 -> R0 = (V_断电首帧 - V_带载末N帧均值) / I_带载均值
 * 滞回 (ON > OFF) 是为了让"带载段"有明确边界, 不会在门限附近反复进出。 */
#define SOH_I_ON_MA            500      /* 进入带载段的电流上门限 (mA) */
#define SOH_I_OFF_MA           200      /* 退出带载段的电流下门限 (mA) */
/* 带载段最短时长 (ms), 太短的段丢弃 —— 滤接触弹跳 / 电流计校准尖峰。
 * 注意: 实际判定用的是帧数 × BMS_UPDATE_PERIOD_MS, 改周期会自动跟随。 */
#define SOH_MIN_PULSE_MS       5000u
/* 带载末 N 帧电压平均, 作为"带载稳态电压" (N=5 即 1s @200ms)。
 * 取大 -> 包络更稳但更容易把电流下降沿的电压回跳算进去 (R0 偏低);
 * 取小 -> 更贴近阶跃瞬间, 但受单帧噪声影响大。换周期时按 ~1s 换算。 */
#define SOH_R0_TAIL_N          2
/* R0 遗忘因子下限 (样本多了以后的跟踪速度)。老化是慢变量, 快收敛比快跟踪重要。 */
#define SOH_R0_ALPHA           0.20f
/* 自适应遗忘因子分母偏置: alpha_eff = max(SOH_R0_ALPHA, 1/(n + N0))。
 * N0 越大, 前几个样本收敛越慢 (越保守); N0=2 时 n=0 -> 1/2, n=1 -> 1/3 ... */
#define SOH_R0_ALPHA_N0        2
/* 前 SOH_R0_MIN_SAMPLE 个样本的单次限幅比例 (±本值)。
 * 防单帧离谱值把某格表带跑; 样本够了就放开 (lim = 1.0)。 */
#define SOH_R0_LIMIT_RATIO     0.20f
/* 该格样本数达此值后才放开上面的限幅 */
#define SOH_R0_MIN_SAMPLE      3
/* 单次 R0 测量的合理区间 (mΩ), 越界丢弃 —— R0 对温度/荷电态敏感,
 * 但物理上 18650 不可能超出这个范围, 越界基本是采样/换算出错。
 * (与 [6] 的 SOC_R0_TABLE_* 分工不同: 这两个判"单次测量", 那组判"写表值") */
#define SOH_R0_LO_MOHM         20
#define SOH_R0_HI_MOHM         200
/* 只接受该温度窗口内的 R0 样本 (°C) —— R0 对温度很敏感,
 * 低温下内阻成倍上升, 混进来会把标定表带歪。窗口外丢弃。 */
#define SOH_TEMP_LO_C          15
#define SOH_TEMP_HI_C          35
/* 内阻翻倍视为寿命终点 (SOH_R = 0 的锚点)。
 * SOH_R = (RATIO - R0_avg/R0_fresh) / (RATIO - 1) × 100。
 * 改小 -> SOH_R 对轻微老化更敏感 (但也更容易受测量噪声影响)。 */
#define SOH_R_EOL_RATIO        2.0f

/* ---- Q 学习 (静置 OCV 锚点法) ----
 * 维护 SOC 最高/最低两个锚点, 放电后两端差值达到下面两个门槛才学一次:
 *   ΔSOC >= SOH_Q_MIN_DSOC_01 且 ΔQ >= SOH_Q_MIN_DQ_MAH
 * 门槛越松 -> 学得越快, 但 ΔSOC 太小时 Q_est 的相对误差会放大
 *           (sigma_Q(%) = SOH_Q_SIG_K / ΔSOC(%)); ΔSOC 小于 10% 时
 *           sigma_Q 超过 12.6%, 等于把系统偏差"学实", 不如不学。
 * 门槛越紧 -> 学得准, 但名义 10% 的放电循环可能永远够不到 15%。 */
#define SOH_Q_MIN_DSOC_01      1500     /* 触发学习的最小 ΔSOC (0.01% 单位, 1500 = 15%) */
#define SOH_Q_MIN_DQ_MAH       200      /* 触发学习的最小 ΔQ (mAh) */

/* ---- Q 融合: 标量卡尔曼滤波 ----
 * 状态 Q 随机游走; 量测 Q_est 方差 R = sigma^2; 正向新息把 R 放大
 * SOH_Q_KF_RUP 倍 -> SOH 上升被自然压住, 不需要死区/阻尼/限幅三个手调常数。
 * 选它不是因为"更准"(和死区方案各有胜负), 而是 sigma 估错时不崩:
 *   死区方案 k = sigma_assumed/sigma_true >= 2 时直接冻结 (波动->0);
 *   卡尔曼在 k=4 时仍在跟踪, 且稳态偏差几乎与 k 无关 (可一次性标定掉)。
 * 参数扫描 (40 次 x 2500 组, 跨度 30~80% 随机):
 *   上跳 0.23%  下跳 1.01%  稳态波动 0.71%  稳态偏差 -1.60%  老化滞后 +0.72%
 * 单次测量的相对 sigma: sigma_Q(%) = SOH_Q_SIG_K / ΔSOC(%)
 *   —— 从锚点对的 Q_est 散布估得, 不需要真值 SOC 曲线, 但随 OCV 表变化。
 *   重标 OCV 表之后这个散布会变小, 建议用 PC 脚本重新估一遍。 */
#define SOH_Q_SIG_K            126.0f   /* sigma_Q(%) = 本值 / ΔSOC(%); 30% -> 4.2% */
#define SOH_Q_KF_P0            0.02f    /* Q 初值相对不确定度 (标称可信到 ±2%) */
#define SOH_Q_KF_Q             0.002f   /* 过程噪声: 两次测量间容量可能的漂移 (相对值)。
                                         * 调大 -> 允许容量学得更"活" (也更抖);
                                         * 调小 -> 容量更稳, 但老化跟得慢 */
#define SOH_Q_KF_RUP           8.0f     /* 正向新息的量测噪声放大倍数 (抑制 SOH 上跳)。
                                         * 调大 -> SOH 更难上升 (防虚高);
                                         * 调小 -> 上升更灵敏 (也可能被噪声抬上去) */

/* =====================================================================
 * [6] 钳位与防呆
 * ===================================================================== */

/* R0 表写入值的存储范围 (mΩ), 越界直接钳位。
 * 与 [5] 的 SOH_R0_LO/HI_MOHM 分工不同:
 *   SOH_R0_LO/HI_MOHM   判"单次测量"是否可信, 不可信就不写 (写表之前)
 *   本组两个宏          判"要写进表"的值是否离谱, 越界钳位 (写表之时)
 * 上限给到 EOL 数倍的余量, 只为拦指针错位 / 未初始化这类硬故障。
 * 下限 20 也用于 SOC_SetR0At 的入口防呆。 */
#define SOC_R0_TABLE_MIN_MOHM  20
#define SOC_R0_TABLE_MAX_MOHM  500

/* SOH_R 的统计网格: 对 10% 网格的 [LO, HI] 段做平均 (索引 0~10)。
 * 默认 1~9 即 10%~90% —— 掐掉两端: 0% 附近 R0 飙高且极少出现,
 * 100% 附近样本少、满充段内阻也不敏感; 计入只会让 SOH_R 无谓抖动。
 * 也可用来只统计某个常用区间 (比如 30~80%: LO=3, HI=8)。 */
#define SOH_R_AVG_LO           1
#define SOH_R_AVG_HI           9

/* 上面的网格段包含几格 (由 LO/HI 自动导出, 不要单独改) */
#define SOH_R_AVG_N            (SOH_R_AVG_HI - SOH_R_AVG_LO + 1)

/* =====================================================================
 * [7] 移植开关
 * ===================================================================== */

/* 时间戳来源:
 *   1 = 调用 BMS_Port_GetTickMs() —— 由目标平台实现 (推荐)
 *   0 = 不使用时间戳: 内部按 BMS_UPDATE_PERIOD_MS 的标称周期自累加。
 *       最省事的接入方式, 但要求主循环周期真的准, 否则安时积分会偏。
 * 两种模式都由 BMS_NowMs() 统一出口 (见 bms_port.c), soc.c / soh.c 不区分。 */
#ifndef BMS_USE_TICK
#define BMS_USE_TICK           1
#endif

/* exp(-x) 来源:
 *   1 = 用 <math.h> 的 expf()  —— 推荐; 需要链接 libm (多数工具链默认已链)
 *   0 = 用库内查表近似 (范围缩减 + 6 阶泰勒, 不依赖 libm, 约 5 次乘加)。
 *       无 FPU 平台上这一项是 EKF 最贵的运算, 换近似可省掉 expf 的调用开销。 */
#ifndef BMS_USE_LIBM_EXPF
#define BMS_USE_LIBM_EXPF      0
#endif

/* =====================================================================
 * [8] 掉电保持 —— SOH 学习结果存进非易失介质
 *
 * 默认关闭: 不动这里时, 本库行为与"没有持久化"完全一致, 零 Flash 零 RAM。
 * 要用就两步:
 *   1) BMS_USE_NVM 改成 1
 *   2) 从 移植示例/ 挑一个 port_nvm_*.c 加进工程 (那 3 个槽函数是
 *      介质相关的, 必须由目标平台提供; 算法库侧一行不用改)
 *
 * 介质优先顺序 (有外部就用外部):
 *   外部 EEPROM / FRAM  >  VBAT 备份寄存器  >  内部 Flash 末尾页
 * 大扇区 MCU (STM32F4/F7/H7, 最小扇区 16~128KB) 用内部 Flash 存 80B 要
 * 报废一整个扇区, 建议走外部。完整选型表见 README 的"持久化"章节。
 * ===================================================================== */

/* 1 = 启用掉电保持; 0 = 相关代码完全不参与编译 */
#ifndef BMS_USE_NVM
#define BMS_USE_NVM            1
#endif

/* 落盘去抖 (ms): 距上次落盘不足本值就不写, 把一轮放电里的多次学习
 * 合并成一次擦写 —— 这是"保寿命"的两大手段之一 (另一个是多槽轮转,
 * 由移植层的 BMS_NVM_SlotCount 返回的槽数决定)。
 * 60000 = 60s: 每天学 10 次 -> 每天 10 次擦写 (2 槽 / 1 万次 -> 5.5 年)。
 * 嫌寿命不够就加大 (300000 = 300s -> 寿命 x5), 代价是掉电最多丢最近
 * 几分钟的学习结果 —— 丢了只是回到上一次, 不会算错。 */
#ifndef BMS_NVM_DEBOUNCE_MS
#define BMS_NVM_DEBOUNCE_MS    60000u
#endif

/* 1 = 落盘前先把序列化结果与"上次落盘内容"逐字节比较, 相同就跳过写入。
 * 很多次置脏其实没改变数据 (比如某格 R0 只动了 0.1mΩ 被取整抹平),
 * 这一条能省掉这些无谓擦写。代价是 68 字节影子缓冲。
 * RAM 极紧 (2KB 级 MCU) 且不在意寿命时可设 0。 */
#ifndef BMS_NVM_SKIP_IDENTICAL
#define BMS_NVM_SKIP_IDENTICAL 1
#endif

/* 落盘格式版本 —— 改了 soh_param_t 的字段或顺序必须 +1。
 * 版本不符会被读回流程判为无效 (回退标称值), 绝不会把新旧格式读串。
 * 必须 >= 1 (0 保留给"空槽"序号, 见 bms_nvm.c)。
 *
 *   ver 1  最初版
 *   ver 2  加温度维度: 62..63 的 2 字节保留位改成
 *          "落盘时的电芯温度 (0.1C, 有符号)"。R0 改为按"温度基准 + 老化
 *          增量"存储, 上电导入要先切回这个温度再导入, 增量才干净。
 *          旧数据会因版本号不符被判无效 -> 回退标称值重新学, 不会读串。
 *   ver 3  加"充电/放电方向 R0 表 + 累计充放电 + 循环计数"。
 *          payload 从 68 字节扩到 120 字节, 但**前 68 字节与 ver 2
 *          逐字节相同** (PC 侧"68 B 参数块"的老流程照旧可读可写),
 *          新增段全部追加在 68 之后。旧数据同样因版本号不符被判无效。 */
#ifndef BMS_NVM_VER
#define BMS_NVM_VER            3u
#endif

/* =====================================================================
 * [9] 在线调参 —— 运行时通过串口 / USB / CAN 改标定表与参数
 *
 * 默认关闭: BMS_USE_TUNE = 0 时 bms_tune.c 完全不参与编译, 零 Flash 零 RAM。
 * 要用就三步:
 *   1) BMS_USE_TUNE 改成 1
 *   2) 把收到的字节喂进来 (主循环):
 *        BMS_TUNE_SetTx(你的发一字节函数);
 *        while(环形缓冲非空) BMS_TUNE_Feed(取一个字节);
 *   3) 上位机按 bms_tune.h 里的帧格式拼命令
 *
 * **中断里只能往环形缓冲塞字节, 绝不能调 BMS_TUNE_Feed**: 主循环的
 * SOC_AhUpdate() 正在读标定表, 中断里改表会读到"一半新一半旧"。
 * 同理 BMS_NVM_Save() 也不能进中断 (擦页要关中断 10~20ms)。
 *
 * **本模块不做鉴权**: 谁能喂字节进来, 谁就能改标定表 / 容量 / SOH 学习
 * 结果。是否开放、什么时候开放由工程侧决定 (上电后 N 秒内允许 / 握手
 * 后才允许 / 按键按下才把串口接到本模块上)。
 *
 * 帧格式与完整命令表见 bms_tune.h。
 * ===================================================================== */

/* 1 = 启用在线调参协议层; 0 = 相关代码完全不参与编译 */
#ifndef BMS_USE_TUNE
#define BMS_USE_TUNE           0
#endif

/* 接收缓冲能装的最大 payload 字节数。
 * 默认跟随标定表整包大小 (3 x 4 x 11 x 2 = 264B) 再加 8B 余量 —— 写成
 * 宏表达式而不是数字, 是为了改 BMS_CAL_TEMP_N 时这里自动跟着变, 不用
 * 记着手动同步。
 * (宏在使用点才展开, 所以此处引用 bms_cal.h 里的 BMS_CAL_BYTES 没问题。
 *  但它是表达式, 不能放进下面的 #if 自检 —— 那里展开时 BMS_CAL_* 还没
 *  定义, 会直接编译报错。)
 * RAM 极紧时可改小, 代价是"读/写标定表整包"这类长命令会被拒 (返回
 * BMS_TUNE_EBADLEN); 单点读写命令不受影响。 */
#ifndef BMS_TUNE_RX_MAX
#define BMS_TUNE_RX_MAX        (BMS_CAL_BYTES + 8u)
#endif

/* 协议版本: 帧格式或命令语义变了就 +1, 上位机靠它判断能不能对话。
 * ver 1 -> 2 的契机: RD/WR_SOH_BLOB 的载荷从 68B 涨到 120B (NVM 结构
 * 扩展到 ver 3), 老上位机按 68B 收会截断, 得能靠 PING 一眼拒绝对话。
 * ※ 这个兜底必须与 bms_tune.h 里的同名兜底**同值**: 两处都是 #ifndef,
 *   谁的 #define 先被预处理到谁生效, 而生效顺序由编译单元的 include
 *   顺序决定 —— 两值不同会让协议版本随编译顺序漂移, 同源码在板子上报
 *   1、在仿真里报 2。改版本号时两处一起改。 */
#ifndef BMS_TUNE_PROTO_VER
#define BMS_TUNE_PROTO_VER     2u
#endif

/* =====================================================================
 * [10] 温度修正 / 倍率修正 / 循环计数
 *
 * 为什么要有这一组:
 *   可用容量同时受温度与放电倍率影响。同一节 18650, 5C 下的可用容量比 25C
 *   少 15~25%, 2C 放电又比 0.2C 少 3~8%。不加修正有两个后果:
 *     (a) 拿低温 / 大倍率数据做实验时, soh.c 会把这部分"容量变少"当成老化
 *         学进去 —— 一次低温试验就能把 SOH 永久拉低十几个百分点;
 *     (b) 安时积分用同一个容量换算, 低温下 SOC 掉得比实际慢。
 *   所以"学到的容量"与"积分用的容量"都要先折算到参考工况。
 *
 * 修正模型 (两个乘性系数, 都归一化到 1.0 = 参考工况):
 *   可用容量  Q_eff = Q_ref × f_T(T) × f_I(I)
 *     f_T  由 SOC_CAP_TEMP_PCT 按温度线性插值 / 100
 *     f_I  Peukert: f_I = (|I| / BMS_REF_CUR_MA) ^ (1 - SOC_PEUKERT_K)
 *   学习时反向折算回参考工况:
 *     Q_ref_est = ΔQ / (ΔSOC × f_T × f_I)
 *
 * **默认参数是恒等的**: SOC_CAP_TEMP_PCT 三点都是 100 且 SOC_PEUKERT_K = 1.0
 *   => f_T ≡ 1 且 f_I ≡ 1 => 行为与加本组之前**逐位相同**。
 *   拿到 5C/45C 与多倍率实测后, 用 脚本/test/fit_temp_rate.py 拟合参数,
 *   改下面两处即生效 —— 与 OCV/R0 表"先占位、后补标定"是同一套做法。
 * ===================================================================== */

/* 参考工况: 所有折算都往这里归。参考温度必须与标定表的中间点一致。 */
#define BMS_REF_TEMP_DC        250      /* 25.0 C */

/* 参考电流 (mA): 容量标称值的定义倍率 = 0.2C。
 * 1500 × 0.2 = 300 —— 与 SOC_CAPACITY_NOMINAL_MAH 的标称条件一致,
 * 也是容量温度系数的常规定义基准。 */
#define BMS_REF_CUR_MA         300

/* 可用容量的温度系数 (% of 参考温度容量), 顺序 = BMS_CAL_TEMP_DC (5/25/45C)。
 * 中间那个点必须是 100。线性插值, 端点平延, 不外推。
 * 占位值 100/100/100 = 不随温度变, 等价于关闭温度修正。
 * 量级参考 (18650 三元, 0.2C): 0C 约 90%, 5C 约 93%, 25C = 100%,
 *   45C 约 101~103%; -20C 可低到 60~70% —— 本表只覆盖 5~45C, 更低温度
 *   靠端点平延, 那一段误差最大; 低温应用请把标定温度点往前加。 */
#define SOC_CAP_TEMP_PCT                             \
{                                                    \
    100,    /*  5 C 占位, 待实测 */                   \
    100,    /* 25 C 参考点, 必须 100 */               \
    100     /* 45 C 占位, 待实测 */                   \
}

/* Peukert 指数 k:  Q(I) = Q_ref × (I/I_ref)^(1-k)。
 *   k = 1.0  -> 无倍率效应 (占位值, 等价于关闭倍率修正)
 *   18650 三元典型 1.02~1.06; LFP 1.05~1.10
 * 由 脚本/test/fit_temp_rate.py 对两条以上不同倍率的放电曲线拟合得到。
 * 合法区间 (1.0, 1.3): 小于 1 意味着"电流越大容量越多"(无物理依据);
 * 大于 1.3 会把 2C 的容量压掉 25% 以上, 显然已不是倍率效应。 */
#define SOC_PEUKERT_K          1.00f

/* 倍率修正的适用电流下限 (mA): |I| 小于本值时按参考倍率算 (f_I = 1)。
 * 理由: 静置 / 漏电流不产生倍率效应; 且 (I/I_ref)^(1-k) 在小电流区会让
 * 系数乱跳。取参考电流的 1/4 左右。 */
#define SOC_RATE_MIN_CUR_MA    150

/* 总修正系数钳位 (f_T × f_I), 挡电流 / 温度读数异常造成的离谱折算。
 * 0.5~1.5 足以覆盖 -20C~45C × 0.1C~3C 的合理范围。 */
#define SOC_CORR_MIN           0.50f
#define SOC_CORR_MAX           1.50f

/* 拟合时对电流比值的钳位 (|I| / I_ref), 超出按端点算。
 * 作用是把 ln() 的近似级数限制在收敛快的区间 (见 bms_cal.c)。 */
#define SOC_RATE_RATIO_LO      0.25f
#define SOC_RATE_RATIO_HI      4.00f

/* ---- 循环次数与累计充放电 ---- */

/* 半循环判定摆幅 (0.01% 单位): SOC 自极低点回升 (或自极高点回落) 超过
 * 本值记半个循环。3000 = 30%。
 * 与"等效满循环"(累计放出电量 / 标称容量) 是两个互补口径:
 *   摆幅法数的是充放次数 (与电池手册的循环寿命同口径, 但受 DOD 影响);
 *   等效满循环数的是总吞吐量 (与 DOD 无关, 适合折算寿命损耗)。
 * 比 SOH_Q_MIN_DSOC_01 (15%) 更严, 免得一个浅循环既学了容量又计了循环。 */
#define SOH_CYCLE_SWING_01     3000

/* 累计充放电的落盘阈值 (% 标称容量): 自上次落盘以来吞吐量涨过这么多
 * 才置脏。**这条是保 Flash 寿命的**: 累计器每帧都在变, 若每帧置脏,
 * BMS_NVM_Task 的去抖就退化成"每 60s 一写"(每天 1440 次), 2 槽 1 万次的
 * 介质十几天就磨穿。100 = 折满一个标称容量才落一次盘, 掉电最多丢一个
 * 循环的计数; 与学习结果共用一份 payload, 额外擦写约等于每天循环数。 */
#define SOH_COUNT_SAVE_PCT     100

/* =====================================================================
 * 编译期一致性自检 —— 参数改冲突了直接编译报错, 不会带病上机
 * ===================================================================== */

#if BMS_UPDATE_PERIOD_MS < 1
#error "BMS_UPDATE_PERIOD_MS 必须 >= 1"
#endif

#if BMS_DT_MAX_MS <= BMS_UPDATE_PERIOD_MS
#error "BMS_DT_MAX_MS (异常帧判据) 必须大于 BMS_UPDATE_PERIOD_MS (正常帧间隔)"
#endif

#if SOC_CAP_LO_PCT >= SOC_CAP_HI_PCT
#error "SOC_CAP_LO_PCT 必须小于 SOC_CAP_HI_PCT"
#endif

#if SOC_CAP_LO_PCT < 1 || SOC_CAP_HI_PCT > 200
#error "SOC_CAP_LO_PCT 取 1~199, SOC_CAP_HI_PCT 取 2~200 (百分比)"
#endif

#if SOC_IDLE_MS < SOH_MIN_REST_MS
#error "SOC_IDLE_MS (重同步静置时长) 不宜小于 SOH_MIN_REST_MS (锚点静置时长)"
#endif

#if SOC_QUIET_DEBOUNCE < 1 || SOH_IDLE_DEBOUNCE < 1
#error "消抖帧数必须 >= 1"
#endif

#if SOH_I_ON_MA <= SOH_I_OFF_MA
#error "SOH_I_ON_MA (进入带载) 必须大于 SOH_I_OFF_MA (退出门限), 否则滞回失效"
#endif

#if SOH_R0_TAIL_N < 1 || SOH_R0_TAIL_N > 32
#error "SOH_R0_TAIL_N 取值范围 1~32 (带载末 N 帧均值)"
#endif

#if SOH_R0_LO_MOHM >= SOH_R0_HI_MOHM
#error "SOH_R0_LO_MOHM 必须小于 SOH_R0_HI_MOHM"
#endif

#if SOH_TEMP_LO_C >= SOH_TEMP_HI_C
#error "SOH_TEMP_LO_C 必须小于 SOH_TEMP_HI_C"
#endif

#if SOH_Q_MIN_DSOC_01 < 100
#error "SOH_Q_MIN_DSOC_01 太小 (<1%), 学到的容量会被系统误差带歪; 建议 >= 1000"
#endif

#if SOH_Q_MIN_DQ_MAH < 1
#error "SOH_Q_MIN_DQ_MAH 必须 >= 1"
#endif

#if SOH_R_AVG_LO < 0 || SOH_R_AVG_HI > 10 || SOH_R_AVG_LO > SOH_R_AVG_HI
#error "SOH_R_AVG_LO/HI 必须在 0~10 且 LO <= HI"
#endif

#if SOC_R0_TABLE_MIN_MOHM >= SOC_R0_TABLE_MAX_MOHM
#error "SOC_R0_TABLE_MIN_MOHM 必须小于 SOC_R0_TABLE_MAX_MOHM"
#endif

#if BMS_USE_NVM && (BMS_NVM_DEBOUNCE_MS < 1000u)
#error "BMS_NVM_DEBOUNCE_MS 小于 1s: 会明显加速非易失介质的磨损"
#endif

#if BMS_NVM_VER < 1u
#error "BMS_NVM_VER 必须 >= 1 (0 保留给'空槽'序号)"
#endif

#if BMS_CAL_TEMP_N != 3u
#error "SOC_CAP_TEMP_PCT 是按 3 个温度点写的; 改 BMS_CAL_TEMP_N 必须同步改本表"
#endif

#if BMS_REF_CUR_MA < 1
#error "BMS_REF_CUR_MA (参考倍率电流) 必须 >= 1 mA"
#endif

#if SOC_RATE_MIN_CUR_MA < 0
#error "SOC_RATE_MIN_CUR_MA 不能为负"
#endif

#if SOH_CYCLE_SWING_01 < 100 || SOH_CYCLE_SWING_01 > 10000
#error "SOH_CYCLE_SWING_01 应在 1%~100% 之间 (0.01% 单位)"
#endif

#if SOH_COUNT_SAVE_PCT < 1 || SOH_COUNT_SAVE_PCT > 10000
#error "SOH_COUNT_SAVE_PCT 应在 1%~100% 之间 (占标称容量的百分比)"
#endif

/* ---- 浮点参数为什么没有编译期自检 ----
 * C 预处理器不认浮点常量, #if 对 EKF 的 Q/R、各种比例系数 (SOH_R0_LIMIT_RATIO
 * / SOH_R_EOL_RATIO / SOH_R0_ALPHA / SOH_Q_KF_*) 都用不了; 用"数组长度为负"
 * 那类技巧又会被 GCC 判为 variably modified 并告警, 而且 C99 之外的工具链
 * 不一定接受。
 * 折中: 本文件所有浮点参数的**合法区间都写在各自的注释里**, 改的时候照着看。
 * 需要重点记住的三条:
 *   SOH_R0_LIMIT_RATIO / SOH_R0_ALPHA / SOH_Q_KF_P0   都必须落在 (0, 1]
 *   SOH_R_EOL_RATIO                                   必须 > 1
 *   BMS_EKF_Q_SOC / Q_VRC / R_V / P0_* / RES_MAX_MV   必须 > 0 */

#endif /* __BMS_CONFIG_H */
