ZZ8874-001/BMC_CMZY_080/Core/Inc/main.h

#define HSE_DIS_Pin GPIO_PIN_1
#define HSE_DIS_GPIO_Port GPIOA
#define RGB_USART2_TX_Pin GPIO_PIN_2
#define RGB_USART2_TX_GPIO_Port GPIOA
#define COMP_BTTN_Pin GPIO_PIN_3
#define COMP_BTTN_GPIO_Port GPIOA
#define COMP_PACK_Pin GPIO_PIN_4
#define COMP_PACK_GPIO_Port GPIOA
#define BUZ_TIM1_CH1_Pin GPIO_PIN_7
#define BUZ_TIM1_CH1_GPIO_Port GPIOA
#define SUP_5V_EN_Pin GPIO_PIN_0
#define SUP_5V_EN_GPIO_Port GPIOB
#define BQ_BOOT_Pin GPIO_PIN_1
#define BQ_BOOT_GPIO_Port GPIOB
#define BQ_ALT_EXTI8_Pin GPIO_PIN_8
#define BQ_ALT_EXTI8_GPIO_Port GPIOA
#define BQ_IIC1_SCL_Pin GPIO_PIN_9
#define BQ_IIC1_SCL_GPIO_Port GPIOA
#define BQ_IIC1_SDA_Pin GPIO_PIN_10
#define BQ_IIC1_SDA_GPIO_Port GPIOA
#define IND_ROHT_Pin GPIO_PIN_3
#define IND_ROHT_GPIO_Port GPIOB
#define IND_NORM_Pin GPIO_PIN_4
#define IND_NORM_GPIO_Port GPIOB
#define WAKE_EXTI5_Pin GPIO_PIN_5
#define WAKE_EXTI5_GPIO_Port GPIOB
