ZZ8874-001/BMC_CMZY_080/App/app/charge_policy.c

/**
 ******************************************************************************
 * @file    charge_policy.c
 * @brief   CHARGE/DISCHARGE/CAL 策略：FET 请求、充电器优先、自动 LP 阻止。
 *
 * 状态优先级：FAULT > CAL > CHARGE(充电器) > DISCHARGE(手势) > IDLE。
 * CHARGE 额外用充电电流兜底 COMP2；近满切 CHG-only，用 DSG 体二极管判充电器。
 * 所有 BQ 写操作都走影子请求；模式切换/CAL/FAULT 在 BQ RUN 且空闲时尝试立即写。
 ******************************************************************************
 */
#include "app/charge_policy.h"

#include "app/power_mode.h"
#include "app/protection.h"
#include "app/self_test.h"
#include "app/state_machine.h"
#include "bsp/bq_ic.h"
#include "bsp/buzzer.h"

#include <stddef.h>

/* 平衡充会故意暂时关断输出（电流先降到 0），若按 1 s 去抖会被误判为
 * 充电器移除，造成 CHARGE→IDLE→CHARGE 反复。5.2 s 覆盖该短暂断流。 */
#define CHARGE_POLICY_CHARGER_LOW_MS 10400u

/* COMP2 在 MOS 导通后只看到 I×(Rshunt+Rds_on)×0.266；100 mA 时仅约 0.3 mV。
 * 充电电流 >30 mA 时用电流保持“充电器存在”；<20 mA 时释放；20–30 mA 回差。
 * 近满（SOC>90 且 -20 mA < I < 220 mA）时关 DSG、保留 CHG，让 DSG 体二极管
 * 提供压降，COMP2 重新可用；电流 >320 mA 或 SOC<85% 退出。 */
#ifndef CHARGE_POLICY_BODY_DIODE_ENABLE
#define CHARGE_POLICY_BODY_DIODE_ENABLE      1u
#endif
#define CHARGE_POLICY_CURRENT_HOLD_MA         30
#define CHARGE_POLICY_CURRENT_RELEASE_MA      20
#define CHARGE_POLICY_NEAR_FULL_ENTER_MA      220
#define CHARGE_POLICY_NEAR_FULL_MIN_MA        (-20) /* 未标定 CC 零点允许的负偏置 */
#define CHARGE_POLICY_NEAR_FULL_EXIT_MA       320
#define CHARGE_POLICY_NEAR_FULL_SOC01         9000u
#define CHARGE_POLICY_NEAR_FULL_EXIT_SOC01    8500u

/* 低电充电状态：参考节<3.1 V 或 SOC<10% 进入（由 Protection 统一判定）；
 * 默认 CHG-only。只有 >200 mA 连续两帧且参考节>=2.8 V 才打开 DSG；
 * <120 mA 或电流无效立即关闭。 */
#define CHARGE_POLICY_LOW_BATT_DSG_ON_MA       200
#define CHARGE_POLICY_LOW_BATT_DSG_OFF_MA      120
#define CHARGE_POLICY_LOW_BATT_MIN_MV          2800u
#define CHARGE_POLICY_LOW_BATT_ON_FRAMES       2u
#define CHARGE_POLICY_LOW_BATT_LP_CURRENT_MA   30

/* DISCHARGE 进入后的前 10 s：净充电电流 >=100 mA 视为外部设备正在充电，
 * 直接切 CHARGE；<=90 mA 释放（10 mA 回差）。输入与 CHARGE 电流判据相同。 */
#define CHARGE_POLICY_DISCHARGE_CHARGE_WINDOW_MS 50000u
#define CHARGE_POLICY_DISCHARGE_CHARGE_SET_MA    200
#define CHARGE_POLICY_DISCHARGE_CHARGE_CLEAR_MA  160

static struct
{
    charge_policy_state_t state;
    uint8_t requested_mask;
    uint8_t last_allow_mask;
    uint8_t user_discharge_enabled;
    uint8_t charger_present;
    uint8_t charger_low_active;
    uint32_t charger_low_since_ms;
    uint8_t lp_block;

    /* 充电电流/SOC 输入与近满体二极管子模式（仅策略启发，不是保护）。 */
    int32_t charge_current_ma;
    uint16_t soc01;
    uint8_t current_valid;
    uint8_t soc_valid;
    uint8_t charge_current_hold;
    uint8_t body_diode_mode;
    uint8_t discharge_charge_detect;

    /* 低电充电状态。 */
    uint8_t  low_batt_dsg_on;
    uint8_t  low_batt_dsg_streak;
    uint32_t low_batt_current_ms;

    uint8_t cal_pending;
    uint8_t cal_active;
    volatile uint8_t cal_mode;       /* Ozone: 写 1 进入，写 0 退出 */
    volatile uint8_t cal_fet_mask;   /* Ozone: 0x00..0x03，先写 mask 再写 mode */
    charge_policy_cal_end_t cal_end_reason;

    uint32_t state_enter_ms;
    uint32_t transition_count;
    uint32_t charge_enter_count;
    uint32_t discharge_enter_count;
    uint32_t fault_off_count;
    uint32_t pair_toggle_count;
    uint32_t pair_reject_count;
    uint32_t cal_enter_count;
    uint32_t cal_abort_count;
    uint32_t apply_now_ok_count;
    uint32_t apply_now_fail_count;
    uint32_t current_hold_count;
    uint32_t body_diode_enter_count;
    uint32_t body_diode_exit_count;
    uint32_t discharge_charge_detect_count;
} s_policy;

static uint8_t ChargePolicy_NormalReady(uint32_t now_ms)
{
    return (uint8_t)((SelfTest_IsDone() != 0u) &&
                     (SelfTest_IsPassed() != 0u) &&
                     (StateMachine_GetState() == SM_STATE_NORM) &&
                     (BQ_GetState() == BQ_ST_RUN) &&
                     (BQ_IsFresh(now_ms) != 0u) &&
                     (PowerMode_GetState() == POWER_STATE_NORM));
}

static uint8_t ChargePolicy_CalReady(uint32_t now_ms)
{
    return (uint8_t)((StateMachine_GetState() != SM_STATE_FAULT) &&
                     (BQ_GetState() == BQ_ST_RUN) &&
                     (BQ_IsFresh(now_ms) != 0u) &&
                     (PowerMode_GetState() == POWER_STATE_NORM));
}

/* 低电充电不依赖 SelfTest/正常充放准入：低电压本身可能让 BQ_DATA 自检失败，
 * 但 CHG 仍必须可以探测/恢复。真实保护锁存仍由 Protection allow 拒绝。 */
static uint8_t ChargePolicy_LowBattReady(uint32_t now_ms,
                                         const charge_policy_input_t *in)
{
    return (uint8_t)((in != NULL) && (in->ref_valid != 0u) &&
                     (StateMachine_GetState() != SM_STATE_FAULT) &&
                     (BQ_GetState() == BQ_ST_RUN) &&
                     (BQ_IsFresh(now_ms) != 0u) &&
                     (BQ_IsRecovering() == 0u) &&
                     (BQ_GetAdcRecoveryFailed() == 0u) &&
                     (PowerMode_GetState() == POWER_STATE_NORM) &&
                     (Protection_GetState() == PROTECTION_NORMAL));
}

/* 只在低电状态内维护 DSG 的 200/120 mA 窗口。 */
static void ChargePolicy_UpdateLowBattDsg(const charge_policy_input_t *in)
{
    if ((in == NULL) || (in->current_valid == 0u) ||
        (in->ref_valid == 0u) ||
        (in->ref_cell_mv < CHARGE_POLICY_LOW_BATT_MIN_MV))
    {
        s_policy.low_batt_dsg_on = 0u;
        s_policy.low_batt_dsg_streak = 0u;
        return;
    }

    if (in->current_ms == s_policy.low_batt_current_ms)
    {
        if (in->charge_current_ma < CHARGE_POLICY_LOW_BATT_DSG_OFF_MA)
        {
            s_policy.low_batt_dsg_on = 0u;
            s_policy.low_batt_dsg_streak = 0u;
        }
        return;
    }
    s_policy.low_batt_current_ms = in->current_ms;

    if (in->charge_current_ma < CHARGE_POLICY_LOW_BATT_DSG_OFF_MA)
    {
        s_policy.low_batt_dsg_on = 0u;
        s_policy.low_batt_dsg_streak = 0u;
    }
    else if (in->charge_current_ma > CHARGE_POLICY_LOW_BATT_DSG_ON_MA)
    {
        if (s_policy.low_batt_dsg_streak < 0xFFu)
        {
            s_policy.low_batt_dsg_streak++;
        }
        if (s_policy.low_batt_dsg_streak >=
            CHARGE_POLICY_LOW_BATT_ON_FRAMES)
        {
            s_policy.low_batt_dsg_on = 1u;
        }
    }
    /* 120–200 mA 保持上一状态。 */
}

/* DISCHARGE 前 10 s 的外部充电兜底；闩锁只在本状态窗口内有效。 */
static void ChargePolicy_UpdateDischargeChargeDetect(uint32_t now_ms)
{
    if (s_policy.state != CHARGE_POLICY_DISCHARGE)
    {
        s_policy.discharge_charge_detect = 0u;
        return;
    }
    if ((now_ms - s_policy.state_enter_ms) >=
        CHARGE_POLICY_DISCHARGE_CHARGE_WINDOW_MS)
    {
        s_policy.discharge_charge_detect = 0u;
        return;
    }
    if (s_policy.charger_present != 0u)
    {
        s_policy.discharge_charge_detect = 0u;
        return;
    }
    if (s_policy.current_valid == 0u)
    {
        return;   /* 不用失效电流置位/清除 */
    }

    if (s_policy.charge_current_ma >= CHARGE_POLICY_DISCHARGE_CHARGE_SET_MA)
    {
        if (s_policy.discharge_charge_detect == 0u)
        {
            s_policy.discharge_charge_detect_count++;
        }
        s_policy.discharge_charge_detect = 1u;
    }
    else if (s_policy.charge_current_ma <=
             CHARGE_POLICY_DISCHARGE_CHARGE_CLEAR_MA)
    {
        s_policy.discharge_charge_detect = 0u;
    }
}

static void ChargePolicy_RequestMask(uint8_t mask)
{
    /* 保护监督层是 FET 允许/禁止的唯一安全门；策略层仍是请求 owner。 */
    mask = (uint8_t)(mask & BQ_FET_MASK_ALL &
                     Protection_GetAllowedFetMask());
    /* 也检查 BQ 影子：LP 进入/监测可能绕过策略直接改过 request_fet_mask。 */
    if ((mask != s_policy.requested_mask) ||
        (BQ_GetFetMaskRequested() != mask))
    {
        BQ_RequestFetMask(mask);
        s_policy.requested_mask = mask;
    }
}

static void ChargePolicy_ApplyNow(uint8_t mask)
{
    mask = (uint8_t)(mask & BQ_FET_MASK_ALL &
                     Protection_GetAllowedFetMask());
    if ((BQ_GetState() == BQ_ST_RUN) && (BQ_IsIdle() != 0u))
    {
        if (BQ_ApplyFetMaskNow(mask) == 0)
        {
            s_policy.apply_now_ok_count++;
        }
        else
        {
            s_policy.apply_now_fail_count++;
        }
    }
}

static void ChargePolicy_SetState(charge_policy_state_t new_state,
                                  uint32_t now_ms, uint8_t announce)
{
    charge_policy_state_t old_state = s_policy.state;

    if (old_state == new_state)
    {
        return;
    }

    s_policy.state = new_state;
    s_policy.state_enter_ms = now_ms;
    s_policy.transition_count++;

    if (new_state != CHARGE_POLICY_CHARGE)
    {
        s_policy.body_diode_mode = 0u;
        if (new_state != CHARGE_POLICY_LOW_BATTERY_CHARGE)
        {
            s_policy.charge_current_hold = 0u;
        }
    }
    s_policy.discharge_charge_detect = 0u;

    if (announce == 0u)
    {
        return;
    }

    if ((new_state == CHARGE_POLICY_CHARGE) ||
        (new_state == CHARGE_POLICY_DISCHARGE) ||
        (new_state == CHARGE_POLICY_CAL))
    {
        Buzzer_StartPattern(BUZZER_PATTERN_WAKE);
    }
    else if ((new_state == CHARGE_POLICY_IDLE) &&
             ((old_state == CHARGE_POLICY_DISCHARGE) ||
              (old_state == CHARGE_POLICY_CAL)))
    {
        Buzzer_StartPattern(BUZZER_PATTERN_LP_ENTER);
    }
}

void ChargePolicy_Init(void)
{
    s_policy.state = CHARGE_POLICY_IDLE;
    s_policy.requested_mask = BQ_FET_MASK_NONE;
    /* 保护层尚未 Init（读到 0）时，首次 Task 会立即收紧到 0，方向安全。 */
    s_policy.last_allow_mask = BQ_FET_MASK_ALL;
    s_policy.user_discharge_enabled = 0u;
    s_policy.charger_present = 0u;
    s_policy.charger_low_active = 0u;
    s_policy.charger_low_since_ms = 0u;
    s_policy.lp_block = 0u;
    s_policy.charge_current_ma = 0;
    s_policy.soc01 = 0u;
    s_policy.current_valid = 0u;
    s_policy.soc_valid = 0u;
    s_policy.charge_current_hold = 0u;
    s_policy.body_diode_mode = 0u;
    s_policy.discharge_charge_detect = 0u;
    s_policy.low_batt_dsg_on = 0u;
    s_policy.low_batt_dsg_streak = 0u;
    s_policy.low_batt_current_ms = 0u;
    s_policy.cal_pending = 0u;
    s_policy.cal_active = 0u;
    s_policy.cal_mode = 0u;
    s_policy.cal_fet_mask = 0u;
    s_policy.cal_end_reason = CHARGE_POLICY_CAL_END_NONE;

    s_policy.state_enter_ms = 0u;
    s_policy.transition_count = 0u;
    s_policy.charge_enter_count = 0u;
    s_policy.discharge_enter_count = 0u;
    s_policy.fault_off_count = 0u;
    s_policy.pair_toggle_count = 0u;
    s_policy.pair_reject_count = 0u;
    s_policy.cal_enter_count = 0u;
    s_policy.cal_abort_count = 0u;
    s_policy.apply_now_ok_count = 0u;
    s_policy.apply_now_fail_count = 0u;
    s_policy.current_hold_count = 0u;
    s_policy.body_diode_enter_count = 0u;
    s_policy.body_diode_exit_count = 0u;
    s_policy.discharge_charge_detect_count = 0u;

    /* 不修改 BQ_DEFAULT_FET_MASK 宏；策略接管后 IDLE 明确请求 0。 */
    BQ_RequestFetMask(BQ_FET_MASK_NONE);
}

void ChargePolicy_OnPairHold3(uint32_t now_ms)
{
    if ((s_policy.state == CHARGE_POLICY_FAULT) ||
        (s_policy.state == CHARGE_POLICY_CAL) ||
        (s_policy.state == CHARGE_POLICY_CHARGE) ||
        (s_policy.state == CHARGE_POLICY_LOW_BATTERY_CHARGE) ||
        (s_policy.cal_mode != 0u) ||
        (s_policy.cal_active != 0u) ||
        (s_policy.charger_present != 0u) ||
        (Protection_IsCellUvActive() != 0u) ||
        (Protection_IsSocCutoffLatched() != 0u) ||
        (ChargePolicy_NormalReady(now_ms) == 0u))
    {
        s_policy.pair_reject_count++;
        return;
    }

    s_policy.user_discharge_enabled ^= 1u;
    s_policy.pair_toggle_count++;
}

void ChargePolicy_OnLpWake(uint32_t now_ms)
{
    s_policy.user_discharge_enabled = 0u;
    s_policy.charger_present = 0u;
    s_policy.charger_low_active = 0u;
    s_policy.charger_low_since_ms = 0u;
    s_policy.charge_current_ma = 0;
    s_policy.soc01 = 0u;
    s_policy.current_valid = 0u;
    s_policy.soc_valid = 0u;
    s_policy.charge_current_hold = 0u;
    s_policy.body_diode_mode = 0u;
    s_policy.discharge_charge_detect = 0u;
    s_policy.low_batt_dsg_on = 0u;
    s_policy.low_batt_dsg_streak = 0u;
    s_policy.low_batt_current_ms = 0u;
    s_policy.cal_pending = 0u;

    if ((s_policy.cal_mode != 0u) || (s_policy.cal_active != 0u))
    {
        s_policy.cal_mode = 0u;
        s_policy.cal_active = 0u;
        s_policy.cal_end_reason = CHARGE_POLICY_CAL_END_LP;
        s_policy.cal_abort_count++;
    }

    ChargePolicy_RequestMask(BQ_FET_MASK_NONE);
    ChargePolicy_ApplyNow(BQ_FET_MASK_NONE);
    ChargePolicy_SetState(CHARGE_POLICY_IDLE, now_ms, 0u);
    s_policy.lp_block = 0u;
}

void ChargePolicy_Task(uint32_t now_ms, uint8_t comp_charging,
                       const charge_policy_input_t *in)
{
    charge_policy_state_t old_state = s_policy.state;
    uint8_t charger_mask_changed = 0u;
    uint8_t allow_mask = Protection_GetAllowedFetMask();
    uint8_t current_hold;

    s_policy.charge_current_ma = 0;
    s_policy.soc01 = 0u;
    s_policy.current_valid = 0u;
    s_policy.soc_valid = 0u;
    if (in != NULL)
    {
        s_policy.charge_current_ma = in->charge_current_ma;
        s_policy.soc01 = (in->soc01 > 10000u) ? 10000u : in->soc01;
        s_policy.current_valid = (in->current_valid != 0u) ? 1u : 0u;
        s_policy.soc_valid = (in->soc_valid != 0u) ? 1u : 0u;
    }

    /* 允许掩码变化（M2 起可能是部分掩码，如只禁 CHG）：立即按新掩码收紧
     * 当前请求；恢复方向由本轮正常 RequestMask 重新放宽，再等 BQ run script。
     * 安全方向不能等 500 ms。 */
    if (allow_mask != s_policy.last_allow_mask)
    {
        uint8_t safe_mask = (uint8_t)(s_policy.requested_mask & allow_mask);
        ChargePolicy_RequestMask(safe_mask);
        ChargePolicy_ApplyNow(safe_mask);
        s_policy.last_allow_mask = allow_mask;
    }

    /* 部分故障/数据未就绪均先关输出；允许掩码可能是部分 DSG。 */
    if ((Protection_GetAllowedFetMask() == BQ_FET_MASK_NONE) &&
        ((s_policy.requested_mask != 0u) ||
         (BQ_GetFetMaskRequested() != 0u) ||
         (BQ_GetFetMaskApplied() != 0u)))
    {
        ChargePolicy_RequestMask(BQ_FET_MASK_NONE);
        ChargePolicy_ApplyNow(BQ_FET_MASK_NONE);
    }

    /* MOS 导通后 COMP2 差模只有 I×(Rshunt+Rds_on)×0.266；100 mA 时约 0.3 mV。
     * CHARGE 中充电电流 >30 mA 置位电流保持，<20 mA 释放，20–30 mA 回差。 */
    if (((s_policy.state == CHARGE_POLICY_CHARGE) ||
         (s_policy.state == CHARGE_POLICY_LOW_BATTERY_CHARGE)) &&
        (s_policy.current_valid != 0u))
    {
        if (s_policy.charge_current_ma > CHARGE_POLICY_CURRENT_HOLD_MA)
        {
            if (s_policy.charge_current_hold == 0u)
            {
                s_policy.current_hold_count++;
            }
            s_policy.charge_current_hold = 1u;
        }
        else if (s_policy.charge_current_ma < CHARGE_POLICY_CURRENT_RELEASE_MA)
        {
            s_policy.charge_current_hold = 0u;
        }
    }
    else
    {
        s_policy.charge_current_hold = 0u;
    }

    current_hold = (((s_policy.state == CHARGE_POLICY_CHARGE) ||
                     (s_policy.state == CHARGE_POLICY_LOW_BATTERY_CHARGE)) &&
                    (s_policy.charge_current_hold != 0u)) ? 1u : 0u;

    ChargePolicy_UpdateDischargeChargeDetect(now_ms);

    /* 充电器：COMP2 高、CHARGE 中电流保持，或 DISCHARGE 前 10 s 的外部充电
     * 闩锁。三者都没有时仍用 5.2 s 低电平去抖（平衡充可短暂关断输出）。 */
    if ((comp_charging != 0u) || (current_hold != 0u) ||
        (s_policy.discharge_charge_detect != 0u))
    {
        s_policy.charger_present = 1u;
        s_policy.charger_low_active = 0u;
        s_policy.charger_low_since_ms = 0u;
    }
    else if (s_policy.charger_present != 0u)
    {
        if (s_policy.charger_low_active == 0u)
        {
            s_policy.charger_low_active = 1u;
            s_policy.charger_low_since_ms = now_ms;
        }
        else if ((now_ms - s_policy.charger_low_since_ms) >=
                 CHARGE_POLICY_CHARGER_LOW_MS)
        {
            s_policy.charger_present = 0u;
            s_policy.charger_low_active = 0u;
            s_policy.charger_low_since_ms = 0u;
        }
    }

    /* 关键故障最高优先级。 */
    if (StateMachine_GetState() == SM_STATE_FAULT)
    {
        if (old_state != CHARGE_POLICY_FAULT)
        {
            s_policy.fault_off_count++;
        }
        if ((s_policy.cal_mode != 0u) || (s_policy.cal_active != 0u))
        {
            s_policy.cal_mode = 0u;
            s_policy.cal_active = 0u;
            s_policy.cal_end_reason = CHARGE_POLICY_CAL_END_FAULT;
            s_policy.cal_abort_count++;
        }
        s_policy.user_discharge_enabled = 0u;
        s_policy.cal_pending = 0u;
        {
            uint8_t request_changed =
                (s_policy.requested_mask != BQ_FET_MASK_NONE) ? 1u : 0u;

            ChargePolicy_RequestMask(BQ_FET_MASK_NONE);
            if ((old_state != CHARGE_POLICY_FAULT) ||
                (request_changed != 0u))
            {
                ChargePolicy_ApplyNow(BQ_FET_MASK_NONE);
            }
        }
        ChargePolicy_SetState(CHARGE_POLICY_FAULT, now_ms, 0u);
        s_policy.lp_block = 1u;
        return;
    }

    /* 调试器 CAL 模式：故障之外最高优先级。 */
    if (s_policy.cal_mode != 0u)
    {
        if (ChargePolicy_CalReady(now_ms) != 0u)
        {
            uint8_t cal_mask = (uint8_t)(s_policy.cal_fet_mask & BQ_FET_MASK_ALL);

            s_policy.user_discharge_enabled = 0u;
            if (s_policy.cal_active == 0u)
            {
                s_policy.cal_active = 1u;
                s_policy.cal_enter_count++;
                s_policy.cal_end_reason = CHARGE_POLICY_CAL_END_NONE;
                charger_mask_changed = 1u;
            }
            if (cal_mask != s_policy.requested_mask)
            {
                charger_mask_changed = 1u;
            }

            s_policy.cal_pending = 0u;
            ChargePolicy_RequestMask(cal_mask);
            if (charger_mask_changed != 0u)
            {
                ChargePolicy_ApplyNow(cal_mask);
            }
            ChargePolicy_SetState(CHARGE_POLICY_CAL, now_ms, 1u);
            s_policy.lp_block = 1u;
            return;
        }

        /* 已经真正进入过 CAL，之后 BQ 不新鲜/非 RUN：自动结束，不自动恢复。 */
        if (s_policy.cal_active != 0u)
        {
            s_policy.cal_active = 0u;
            s_policy.cal_mode = 0u;
            s_policy.user_discharge_enabled = 0u;
            s_policy.cal_end_reason = CHARGE_POLICY_CAL_END_NOTREADY;
            s_policy.cal_abort_count++;
        }
        else
        {
            /* 调试器先写 cal_mode、BQ 还没就绪：保持 pending，阻止自动 LP。 */
            s_policy.cal_pending = 1u;
            s_policy.user_discharge_enabled = 0u;
            ChargePolicy_RequestMask(BQ_FET_MASK_NONE);
            ChargePolicy_SetState(CHARGE_POLICY_IDLE, now_ms, 0u);
            s_policy.lp_block = 1u;
            return;
        }
    }

    /* cal_mode 被清 0：如果会话还在，记录 USER 结束。 */
    if ((s_policy.cal_mode == 0u) && (s_policy.cal_active != 0u))
    {
        s_policy.cal_active = 0u;
        s_policy.cal_end_reason = CHARGE_POLICY_CAL_END_USER;
    }
    s_policy.cal_pending = 0u;

    /* 亏电充电：CHG 默认常开，不等待 charger_present，打破
     * “CHG 关 → 无电流 → 检测不到充电器”的死锁。 */
    if ((Protection_IsLowBattery() != 0u) ||
        (Protection_IsCellUvActive() != 0u))
    {
        s_policy.user_discharge_enabled = 0u;

        if (ChargePolicy_LowBattReady(now_ms, in) != 0u)
        {
            ChargePolicy_UpdateLowBattDsg(in);
            ChargePolicy_RequestMask((s_policy.low_batt_dsg_on != 0u) ?
                                     BQ_FET_MASK_ALL : BQ_FET_MASK_CHG);
            ChargePolicy_SetState(CHARGE_POLICY_LOW_BATTERY_CHARGE,
                                  now_ms, 0u);
            s_policy.lp_block =
                ((s_policy.charger_present != 0u) ||
                 (s_policy.low_batt_dsg_on != 0u) ||
                 ((in != NULL) && (in->current_valid != 0u) &&
                  (in->charge_current_ma >
                   CHARGE_POLICY_LOW_BATT_LP_CURRENT_MA))) ? 1u : 0u;
        }
        else
        {
            s_policy.low_batt_dsg_on = 0u;
            s_policy.low_batt_dsg_streak = 0u;
            ChargePolicy_RequestMask(BQ_FET_MASK_NONE);
            ChargePolicy_SetState(CHARGE_POLICY_LOW_BATTERY_CHARGE,
                                  now_ms, 0u);
            s_policy.lp_block = (s_policy.charger_present != 0u) ? 1u : 0u;
        }
        return;
    }

    s_policy.low_batt_dsg_on = 0u;
    s_policy.low_batt_dsg_streak = 0u;

    /* 正常充放状态。 */
    if (ChargePolicy_NormalReady(now_ms) != 0u)
    {
        if (s_policy.charger_present != 0u)
        {
            uint8_t want_body = s_policy.body_diode_mode;
            uint8_t body_changed = 0u;
            uint8_t charge_mask;

#if (CHARGE_POLICY_BODY_DIODE_ENABLE != 0u)
            if (s_policy.body_diode_mode == 0u)
            {
                /* 近满且电流在 -20..220 mA：关 DSG，保留 CHG；DSG 体二极管抬高 COMP2 差模。 */
                if ((s_policy.current_valid != 0u) &&
                    (s_policy.soc_valid != 0u) &&
                    (s_policy.soc01 > CHARGE_POLICY_NEAR_FULL_SOC01) &&
                    (s_policy.charge_current_ma > CHARGE_POLICY_NEAR_FULL_MIN_MA) &&
                    (s_policy.charge_current_ma <
                     CHARGE_POLICY_NEAR_FULL_ENTER_MA) &&
                    ((Protection_GetAllowedFetMask() & BQ_FET_MASK_CHG) != 0u))
                {
                    want_body = 1u;
                }
            }
            else
            {
                /* 电流/SOC 无效时保持体二极管模式，避免重新开 DSG 后再次丢 COMP2。 */
                if ((s_policy.current_valid != 0u) &&
                    (s_policy.charge_current_ma > CHARGE_POLICY_NEAR_FULL_EXIT_MA))
                {
                    want_body = 0u;
                }
                if ((s_policy.soc_valid != 0u) &&
                    (s_policy.soc01 < CHARGE_POLICY_NEAR_FULL_EXIT_SOC01))
                {
                    want_body = 0u;
                }
                if ((Protection_GetAllowedFetMask() & BQ_FET_MASK_CHG) == 0u)
                {
                    want_body = 0u;
                }
            }
#else
            want_body = 0u;
#endif

            if (want_body != s_policy.body_diode_mode)
            {
                s_policy.body_diode_mode = want_body;
                s_policy.charger_low_active = 0u;
                s_policy.charger_low_since_ms = 0u;
                body_changed = 1u;
                if (want_body != 0u)
                {
                    s_policy.body_diode_enter_count++;
                }
                else
                {
                    s_policy.body_diode_exit_count++;
                }
            }

            charge_mask = (s_policy.body_diode_mode != 0u) ?
                          BQ_FET_MASK_CHG : BQ_FET_MASK_ALL;
            s_policy.user_discharge_enabled = 0u;
            ChargePolicy_RequestMask(charge_mask);
            if (body_changed != 0u)
            {
                ChargePolicy_ApplyNow(charge_mask);
            }
            if (s_policy.state != CHARGE_POLICY_CHARGE)
            {
                s_policy.charge_enter_count++;
            }
            ChargePolicy_SetState(CHARGE_POLICY_CHARGE, now_ms, 1u);
            s_policy.lp_block = 1u;
        }
        else if (s_policy.user_discharge_enabled != 0u)
        {
            ChargePolicy_RequestMask(BQ_FET_MASK_ALL);
            if (s_policy.state != CHARGE_POLICY_DISCHARGE)
            {
                s_policy.discharge_enter_count++;
            }
            ChargePolicy_SetState(CHARGE_POLICY_DISCHARGE, now_ms, 1u);
            s_policy.lp_block = 1u;
        }
        else
        {
            ChargePolicy_RequestMask(BQ_FET_MASK_NONE);
            ChargePolicy_SetState(CHARGE_POLICY_IDLE, now_ms, 1u);
            s_policy.lp_block = 0u;
        }
    }
    else
    {
        s_policy.user_discharge_enabled = 0u;
        ChargePolicy_RequestMask(BQ_FET_MASK_NONE);
        ChargePolicy_SetState(CHARGE_POLICY_IDLE, now_ms, 0u);
        s_policy.lp_block = 0u;
    }

    /* CAL 退出到 IDLE 时尽力立即关管；失败仍由影子在下一轮同步。 */
    if ((old_state == CHARGE_POLICY_CAL) &&
        (s_policy.state == CHARGE_POLICY_IDLE) &&
        (s_policy.requested_mask == BQ_FET_MASK_NONE))
    {
        ChargePolicy_ApplyNow(BQ_FET_MASK_NONE);
    }
}

charge_policy_state_t ChargePolicy_GetState(void)
{
    return s_policy.state;
}

uint8_t ChargePolicy_GetRequestedMask(void)
{
    return s_policy.requested_mask;
}

uint8_t ChargePolicy_IsLpBlocked(void)
{
    return s_policy.lp_block;
}

uint8_t ChargePolicy_IsCalibration(void)
{
    return (uint8_t)((s_policy.state == CHARGE_POLICY_CAL) ||
                     (s_policy.cal_mode != 0u));
}

uint8_t ChargePolicy_IsChargerPresent(void)
{
    return s_policy.charger_present;
}

uint8_t ChargePolicy_GetBodyDiodeMode(void)
{
    return s_policy.body_diode_mode;
}

uint8_t ChargePolicy_GetChargeCurrentHold(void)
{
    return s_policy.charge_current_hold;
}

uint8_t ChargePolicy_GetDischargeChargeDetect(void)
{
    return s_policy.discharge_charge_detect;
}

uint32_t ChargePolicy_GetDischargeChargeDetectCount(void)
{
    return s_policy.discharge_charge_detect_count;
}

uint8_t ChargePolicy_GetLowBattDsgOn(void)
{
    return s_policy.low_batt_dsg_on;
}

charge_policy_cal_end_t ChargePolicy_GetCalEndReason(void)
{
    return s_policy.cal_end_reason;
}
