ZZ8874-001/BMC_CMZY_080/App/app/black_box.c

/**
 ******************************************************************************
 * @file    black_box.c
 * @brief   黑匣子 Flash 环形日志：12 页 × 85 条 × 24 B = 1020 条（≈21 天）。
 *
 * 记录布局（小端，手动逐字节打包）：
 *   off  0: seq        u32   全局自增序号（0xFFFFFFFF 表示空白槽）
 *   off  4: uptime_s   u32   累计通电运行秒（LP 期间不计）
 *   off  8: cell1_mv   u16
 *   off 10: cell2_mv   u16
 *   off 12: cell3_mv   u16
 *   off 14: pack_mv    u16
 *   off 16: cc_raw     i16
 *   off 18: ts1_raw    u16
 *   off 20: flags      u16   bit2:0 记录种类，bit5:3 唤醒原因
 *   off 22: crc16      u16   CRC-16-CCITT(0xFFFF 初值) 覆盖前 22 B
 *
 * 写入策略：仅在主循环、仅 NORM；跨页首槽先擦除整页（~25 ms 取指停摆）。
 * 断电安全：擦除后未写入的空白槽在下次上电时被跳过，seq 从上一个有效头接续。
 ******************************************************************************
 */
#include "app/black_box.h"

#include "board.h"
#include "bsp/bq_ic.h"
#include "bsp/flash_store.h"
#include "app/faults.h"
#include "app/power_mode.h"

#define BB_SLOT_BYTES       24u
#define BB_SLOT_COUNT       BB_RECORD_COUNT          /* 1020 */
#define BB_BLANK_U32        0xFFFFFFFFUL

_Static_assert(BB_RECORD_BYTES == 24u, "Black-box record must remain 24 B");
_Static_assert((BB_RECORD_BYTES % 8u) == 0u,
               "Black-box record must be doubleword programmable");
_Static_assert((BB_KIND_EVENT & BB_PERIODIC_Q_PARTIAL) == 0u,
               "Periodic quality flags must not alter record kind bits");

typedef struct
{
    uint32_t seq;
    uint32_t uptime_s;
    uint16_t cell_mv[3];
    uint16_t pack_mv;
    int16_t cc_raw;
    uint16_t ts1_raw;
    uint16_t flags;
    uint16_t crc16;
} bb_record_t;

static struct
{
    uint8_t valid_head;
    uint16_t head_slot;
    uint32_t head_seq;
    uint32_t uptime_base;
    uint16_t next_slot;         /* 0..1019 */
    uint32_t writes;
    uint32_t erase_count;
    uint32_t write_fail_count;
    uint32_t erase_fail_count;
    uint32_t skipped_bad_records;
    uint8_t err;
} s_bb;

/* RAM 影子：上电后从 Flash 头记录向前取最近 BB_SHADOW_COUNT 条，写记录时
 * 同步前插；只写 RAM，不消耗 Flash。 */
bb_shadow_t s_bb_shadow;

/* ---------------- 工具 ---------------- */
static uint16_t Bb_Crc16(const uint8_t *data, uint32_t len)
{
    uint16_t crc = 0xFFFFu;
    uint32_t i;
    uint8_t bit;

    for (i = 0u; i < len; i++)
    {
        crc ^= (uint16_t)((uint16_t)data[i] << 8);
        for (bit = 0u; bit < 8u; bit++)
        {
            if ((crc & 0x8000u) != 0u)
            {
                crc = (uint16_t)((crc << 1) ^ 0x1021u);
            }
            else
            {
                crc = (uint16_t)(crc << 1);
            }
        }
    }
    return crc;
}

static uint32_t Bb_SlotAddr(uint16_t slot)
{
    uint16_t page = (uint16_t)(slot / BB_RECORDS_PER_PAGE);
    uint16_t index = (uint16_t)(slot % BB_RECORDS_PER_PAGE);

    return BB_FLASH_BASE + ((uint32_t)page * BB_FLASH_PAGE_SIZE) +
           ((uint32_t)index * BB_SLOT_BYTES);
}

static void Bb_Pack(const bb_record_t *rec, uint8_t out[BB_SLOT_BYTES])
{
    uint16_t crc;

    out[0]  = (uint8_t)(rec->seq & 0xFFu);
    out[1]  = (uint8_t)((rec->seq >> 8) & 0xFFu);
    out[2]  = (uint8_t)((rec->seq >> 16) & 0xFFu);
    out[3]  = (uint8_t)((rec->seq >> 24) & 0xFFu);
    out[4]  = (uint8_t)(rec->uptime_s & 0xFFu);
    out[5]  = (uint8_t)((rec->uptime_s >> 8) & 0xFFu);
    out[6]  = (uint8_t)((rec->uptime_s >> 16) & 0xFFu);
    out[7]  = (uint8_t)((rec->uptime_s >> 24) & 0xFFu);

    out[8]  = (uint8_t)(rec->cell_mv[0] & 0xFFu);
    out[9]  = (uint8_t)((rec->cell_mv[0] >> 8) & 0xFFu);
    out[10] = (uint8_t)(rec->cell_mv[1] & 0xFFu);
    out[11] = (uint8_t)((rec->cell_mv[1] >> 8) & 0xFFu);
    out[12] = (uint8_t)(rec->cell_mv[2] & 0xFFu);
    out[13] = (uint8_t)((rec->cell_mv[2] >> 8) & 0xFFu);
    out[14] = (uint8_t)(rec->pack_mv & 0xFFu);
    out[15] = (uint8_t)((rec->pack_mv >> 8) & 0xFFu);
    out[16] = (uint8_t)((uint16_t)rec->cc_raw & 0xFFu);
    out[17] = (uint8_t)(((uint16_t)rec->cc_raw >> 8) & 0xFFu);
    out[18] = (uint8_t)(rec->ts1_raw & 0xFFu);
    out[19] = (uint8_t)((rec->ts1_raw >> 8) & 0xFFu);
    out[20] = (uint8_t)(rec->flags & 0xFFu);
    out[21] = (uint8_t)((rec->flags >> 8) & 0xFFu);

    crc = Bb_Crc16(out, 22u);
    out[22] = (uint8_t)(crc & 0xFFu);
    out[23] = (uint8_t)((crc >> 8) & 0xFFu);
}

static uint32_t Bb_ReadU32(const uint8_t *p)
{
    return (uint32_t)p[0] | ((uint32_t)p[1] << 8) |
           ((uint32_t)p[2] << 16) | ((uint32_t)p[3] << 24);
}

static uint16_t Bb_ReadU16(const uint8_t *p)
{
    return (uint16_t)((uint16_t)p[0] | ((uint16_t)p[1] << 8));
}

static uint8_t Bb_SlotValid(const uint8_t *p)
{
    uint16_t crc;

    if (Bb_ReadU32(p) == BB_BLANK_U32)
    {
        return 0u;
    }
    crc = Bb_Crc16(p, 22u);
    return (crc == Bb_ReadU16(p + 22)) ? 1u : 0u;
}

static uint8_t Bb_DecodeWakeMask(uint8_t kind, uint16_t flags)
{
    uint8_t raw = (uint8_t)((flags >> 3) & 0x07u);

    if (kind == BB_KIND_WAKE_MASK)
    {
        return (uint8_t)(raw & (POWER_WAKE_RTC | POWER_WAKE_BUTTON |
                                POWER_WAKE_BQ_ALERT));
    }
    if (kind == BB_KIND_WAKE)
    {
        switch (raw)
        {
        case BB_WAKE_RTC:
            return POWER_WAKE_RTC;
        case BB_WAKE_BUTTON:
            return POWER_WAKE_BUTTON;
        case BB_WAKE_BQ_ALERT:
            return POWER_WAKE_BQ_ALERT;
        default:
            return 0u;
        }
    }
    return 0u;
}

static int Bb_DecodeSlot(uint16_t slot, black_box_record_t *out)
{
    const uint8_t *p;

    if ((out == NULL) || (slot >= BB_SLOT_COUNT))
    {
        return -1;
    }

    p = (const uint8_t *)Bb_SlotAddr(slot);
    if (Bb_SlotValid(p) == 0u)
    {
        return -1;
    }

    out->seq = Bb_ReadU32(p);
    out->uptime_s = Bb_ReadU32(p + 4u);
    out->cell_mv[0] = Bb_ReadU16(p + 8u);
    out->cell_mv[1] = Bb_ReadU16(p + 10u);
    out->cell_mv[2] = Bb_ReadU16(p + 12u);
    out->pack_mv = Bb_ReadU16(p + 14u);
    out->cc_raw = (int16_t)Bb_ReadU16(p + 16u);
    out->ts1_raw = Bb_ReadU16(p + 18u);
    out->flags = Bb_ReadU16(p + 20u);
    out->kind = (uint8_t)(out->flags & 0x07u);
    out->wake_mask = Bb_DecodeWakeMask(out->kind, out->flags);
    out->event_code = (out->kind == BB_KIND_EVENT) ?
                      (uint16_t)((out->flags >> 6) & 0x03FFu) : 0u;
    out->quality_flags = (out->kind == BB_KIND_PERIODIC) ?
                         (uint16_t)(out->flags & BB_PERIODIC_Q_ALL) : 0u;
    out->valid = 1u;
    return 0;
}

static void Bb_PublicFromRecord(const bb_record_t *src, black_box_record_t *dst)
{
    dst->seq = src->seq;
    dst->uptime_s = src->uptime_s;
    dst->cell_mv[0] = src->cell_mv[0];
    dst->cell_mv[1] = src->cell_mv[1];
    dst->cell_mv[2] = src->cell_mv[2];
    dst->pack_mv = src->pack_mv;
    dst->cc_raw = src->cc_raw;
    dst->ts1_raw = src->ts1_raw;
    dst->flags = src->flags;
    dst->kind = (uint8_t)(src->flags & 0x07u);
    dst->wake_mask = Bb_DecodeWakeMask(dst->kind, dst->flags);
    dst->event_code = (dst->kind == BB_KIND_EVENT) ?
                      (uint16_t)((dst->flags >> 6) & 0x03FFu) : 0u;
    dst->quality_flags = (dst->kind == BB_KIND_PERIODIC) ?
                         (uint16_t)(dst->flags & BB_PERIODIC_Q_ALL) : 0u;
    dst->valid = 1u;
}

static void Bb_ShadowLoad(void)
{
    uint16_t slot;
    uint8_t i;

    s_bb_shadow.count = 0u;
    for (i = 0u; i < BB_SHADOW_COUNT; i++)
    {
        s_bb_shadow.rec[i].valid = 0u;
    }
    if (s_bb.valid_head == 0u)
    {
        return;
    }

    slot = s_bb.head_slot;
    for (i = 0u; i < BB_SHADOW_COUNT; i++)
    {
        black_box_record_t rec;

        if (Bb_DecodeSlot(slot, &rec) != 0)
        {
            break;
        }
        s_bb_shadow.rec[i] = rec;
        s_bb_shadow.count = (uint8_t)(i + 1u);
        slot = (uint16_t)((slot + BB_SLOT_COUNT - 1u) % BB_SLOT_COUNT);
    }
}

static void Bb_ShadowPush(const bb_record_t *rec)
{
    uint8_t i;

    for (i = BB_SHADOW_COUNT - 1u; i > 0u; i--)
    {
        s_bb_shadow.rec[i] = s_bb_shadow.rec[i - 1u];
    }
    Bb_PublicFromRecord(rec, &s_bb_shadow.rec[0]);
    if (s_bb_shadow.count < BB_SHADOW_COUNT)
    {
        s_bb_shadow.count++;
    }
}

/* ---------------- 上电头查找 ---------------- */
void BlackBox_Init(void)
{
    uint16_t slot;
    uint32_t best_seq = 0u;
    uint16_t best_slot = 0u;
    uint8_t found = 0u;

    s_bb.valid_head = 0u;
    s_bb.head_slot = 0u;
    s_bb.head_seq = 0u;
    s_bb.uptime_base = 0u;
    s_bb.next_slot = 0u;
    s_bb.writes = 0u;
    s_bb.erase_count = 0u;
    s_bb.write_fail_count = 0u;
    s_bb.erase_fail_count = 0u;
    s_bb.skipped_bad_records = 0u;
    s_bb.err = 0u;
    s_bb_shadow.count = 0u;

    /* 固件不得侵入页 48–63，否则擦写会破坏代码。 */
    if ((uint32_t)&_image_end > APP_FLASH_END)
    {
        s_bb.err = 2u;
        Fault_SetSticky(FAULT_BIT_FLASH_LOG);
        return;
    }

    for (slot = 0u; slot < BB_SLOT_COUNT; slot++)
    {
        const uint8_t *p = (const uint8_t *)Bb_SlotAddr(slot);

        if (Bb_SlotValid(p) == 0u)
        {
            if (Bb_ReadU32(p) != BB_BLANK_U32)
            {
                s_bb.skipped_bad_records++;
            }
            continue;
        }

        {
            uint32_t seq = Bb_ReadU32(p);

            if ((found == 0u) || (seq > best_seq))
            {
                best_seq = seq;
                best_slot = slot;
                found = 1u;
            }
        }
    }

    if (found != 0u)
    {
        const uint8_t *p = (const uint8_t *)Bb_SlotAddr(best_slot);

        s_bb.valid_head = 1u;
        s_bb.head_slot = best_slot;
        s_bb.head_seq = best_seq;
        s_bb.uptime_base = Bb_ReadU32(p + 4u);
        s_bb.next_slot = (uint16_t)((best_slot + 1u) % BB_SLOT_COUNT);
    }
    else
    {
        s_bb.next_slot = 0u;
    }

    Bb_ShadowLoad();
}

uint32_t BlackBox_GetUptimeBase(void)
{
    return s_bb.uptime_base;
}

uint8_t BlackBox_HasError(void)
{
    return s_bb.err;
}

uint16_t BlackBox_GetHeadSlot(void)
{
    return s_bb.head_slot;
}

uint32_t BlackBox_GetHeadSeq(void)
{
    return s_bb.head_seq;
}

int BlackBox_ReadNewest(black_box_record_t *out)
{
    if (s_bb.valid_head == 0u)
    {
        return -1;
    }
    return Bb_DecodeSlot(s_bb.head_slot, out);
}

int BlackBox_ReadSlot(uint16_t slot, black_box_record_t *out)
{
    return Bb_DecodeSlot(slot, out);
}

uint8_t BlackBox_GetShadowCount(void)
{
    return s_bb_shadow.count;
}

int BlackBox_ReadShadow(uint8_t index, black_box_record_t *out)
{
    if ((out == NULL) || (index >= s_bb_shadow.count) ||
        (index >= BB_SHADOW_COUNT) || (s_bb_shadow.rec[index].valid == 0u))
    {
        return -1;
    }
    *out = s_bb_shadow.rec[index];
    return 0;
}

/* ---------------- 写记录 ---------------- */
static int Bb_WriteRecordSnapshot(uint32_t uptime_s, uint16_t flags,
                                  const bq_snapshot_t *snap)
{
    bb_record_t rec;
    uint8_t raw[BB_SLOT_BYTES];
    uint32_t addr;
    uint32_t seq;

    if ((snap == NULL) || (s_bb.err == 2u))
    {
        return -1;
    }

    /* 新记录紧接头序号；跳过 0xFFFFFFFF 空白哨兵。 */
    seq = s_bb.valid_head ? (s_bb.head_seq + 1u) : 1u;
    if (seq == BB_BLANK_U32)
    {
        seq = 1u;
    }

    addr = Bb_SlotAddr(s_bb.next_slot);

    /* 跨页首槽：先擦除本页（页内其他记录都是更老的记录）。 */
    if ((s_bb.next_slot % BB_RECORDS_PER_PAGE) == 0u)
    {
        if (Fs_ErasePage(addr) != 0)
        {
            s_bb.erase_fail_count++;
            s_bb.err = 1u;
            Fault_SetSticky(FAULT_BIT_FLASH_LOG);
            return -1;
        }
        s_bb.erase_count++;
    }

    rec.seq = seq;
    rec.uptime_s = uptime_s;
    rec.cell_mv[0] = snap->cell_mv[0];
    rec.cell_mv[1] = snap->cell_mv[1];
    /* 记录只写真实可信值；异常时控制值可能是估算，绝不落盘。 */
    rec.cell_mv[2] = (snap->log_cell3_valid != 0u) ? snap->cell_mv[2] : 0u;
    rec.pack_mv = (snap->log_pack_valid != 0u) ? snap->pack_mv : 0u;
    rec.cc_raw = snap->cc_raw;
    rec.ts1_raw = snap->ts1_raw;
    rec.flags = flags;
    rec.crc16 = 0u;

    Bb_Pack(&rec, raw);

    if (Fs_ProgramDwords(addr, raw, BB_RECORD_BYTES) != 0)
    {
        s_bb.write_fail_count++;
        s_bb.err = 1u;
        Fault_SetSticky(FAULT_BIT_FLASH_LOG);
        return -1;
    }

    s_bb.valid_head = 1u;
    s_bb.head_slot = s_bb.next_slot;
    s_bb.head_seq = seq;
    s_bb.uptime_base = uptime_s;
    s_bb.next_slot = (uint16_t)((s_bb.next_slot + 1u) % BB_SLOT_COUNT);
    s_bb.writes++;
    s_bb.err = 0u;
    Bb_ShadowPush(&rec);
    return 0;
}

static int Bb_WriteRecord(uint32_t uptime_s, uint16_t flags)
{
    bq_snapshot_t snap;

    BQ_GetSnapshot(&snap);
    return Bb_WriteRecordSnapshot(uptime_s, flags, &snap);
}

int BlackBox_WritePeriodic(uint32_t uptime_s)
{
    bq_snapshot_t snap;
    uint16_t flags = (uint16_t)(BB_KIND_PERIODIC & 0x07u);

    BQ_GetSnapshot(&snap);
    if ((snap.fresh == 0u) || (snap.valid == 0u))
    {
        return -1;
    }
    return Bb_WriteRecordSnapshot(uptime_s, flags, &snap);
}

int BlackBox_WritePeriodicSnapshot(const bq_snapshot_t *snap, uint32_t uptime_s)
{
    uint16_t flags = (uint16_t)(BB_KIND_PERIODIC & 0x07u);

    if ((snap == NULL) || (snap->fresh == 0u) || (snap->valid == 0u))
    {
        return -1;
    }
    return Bb_WriteRecordSnapshot(uptime_s, flags, snap);
}

int BlackBox_WritePeriodicQualified(const bq_snapshot_t *snap, uint32_t uptime_s,
                                    uint16_t quality_flags)
{
    bq_snapshot_t archive;
    uint16_t missing;

    if ((snap == NULL) || ((quality_flags & (uint16_t)~BB_PERIODIC_Q_ALL) != 0u))
    {
        return -1;
    }
    missing = (uint16_t)(quality_flags & BB_PERIODIC_Q_MISSING_MASK);
    if ((quality_flags & BB_PERIODIC_Q_PARTIAL) == 0u)
    {
        /* 电压 FULL 可同时带 SOC_ESTIMATED/SOC_INVALID；只有缺失电压
         * 才要求显式 PARTIAL，避免把 SOC 来源和电压来源混为一谈。 */
        if ((missing != 0u) || (snap->fresh == 0u) || (snap->valid == 0u))
        {
            return -1;
        }
    }
    else if (missing == 0u)
    {
        return -1;
    }

    /* 仅在这条显式 API 接受无效快照；调用者提供的非缺失电压是同批实测，
     * 被标为 MISSING 的字段无论入参为何一律写 0，避免旧发布值冒充。 */
    archive = *snap;
    if ((missing & BB_PERIODIC_Q_CELL1_MISSING) != 0u)
    {
        archive.cell_mv[0] = 0u;
    }
    if ((missing & BB_PERIODIC_Q_CELL2_MISSING) != 0u)
    {
        archive.cell_mv[1] = 0u;
    }
    if ((missing & BB_PERIODIC_Q_CELL3_MISSING) != 0u)
    {
        archive.cell_mv[2] = 0u;
    }
    if ((missing & BB_PERIODIC_Q_PACK_MISSING) != 0u)
    {
        archive.pack_mv = 0u;
    }
    if ((quality_flags & BB_PERIODIC_Q_CC_INVALID) != 0u)
    {
        archive.cc_raw = 0;
    }
    if ((quality_flags & BB_PERIODIC_Q_TS1_INVALID) != 0u)
    {
        archive.ts1_raw = 0u;
    }

    return Bb_WriteRecordSnapshot(uptime_s,
                                  (uint16_t)(BB_KIND_PERIODIC | quality_flags),
                                  &archive);
}

int BlackBox_WriteTransition(uint8_t transition_kind, uint8_t wake_cause,
                             uint32_t uptime_s)
{
    uint16_t flags;

    flags = (uint16_t)((transition_kind & 0x07u) |
                       ((uint16_t)(wake_cause & 0x07u) << 3));
    return Bb_WriteRecord(uptime_s, flags);
}

int BlackBox_WriteWake(uint8_t power_wake_mask, uint32_t uptime_s)
{
    uint16_t flags = (uint16_t)(BB_KIND_WAKE_MASK |
                                ((uint16_t)(power_wake_mask & 0x07u) << 3));

    return Bb_WriteRecord(uptime_s, flags);
}

int BlackBox_WriteEvent(uint16_t event_code, uint32_t uptime_s)
{
    uint16_t flags = (uint16_t)(BB_KIND_EVENT |
                                ((uint16_t)(event_code & 0x03FFu) << 6));

    return Bb_WriteRecord(uptime_s, flags);
}
