ZZ8874-001/BMC_CMZY_080/App/app/black_box.h

/**
 ******************************************************************************
 * @file    black_box.h
 * @brief   黑匣子 Flash 环形日志（页 52–63，1020 条 × 24 B）。
 *
 * 记录由主循环/轻量 LP 写入：30 min 一条周期记录 + 真实唤醒记录。
 * 上电扫描取 seq 最大者为头，写入点紧随其后；跨页首槽前先擦除整页。
 * 记录格式见 black_box.c 顶部注释。
 ******************************************************************************
 */
#ifndef APP_BLACK_BOX_H
#define APP_BLACK_BOX_H

#include <stdint.h>

#include "bsp/bq_ic.h"

/* 记录种类（写入 flags 低 3 位）。 */
#define BB_KIND_PERIODIC    0u
#define BB_KIND_LP_ENTER    1u   /* legacy decoder only; reset-based LP does not write it */
#define BB_KIND_WAKE        2u   /* 兼容旧记录：wake 字段 0..3 */
#define BB_KIND_WAKE_MASK   3u   /* 新记录：wake 字段直接存 POWER_WAKE_* 位图 */
#define BB_KIND_EVENT       4u   /* 事件：flags[15:6] 为 event_code */

/* 仅 BB_KIND_PERIODIC 使用 flags[14:6]；旧 24 B 格式与 CRC 不变。
 * FULL=0 保持旧记录兼容。PARTIAL 必须同时标示缺失的实测电压；缺失
 * 值落盘为 0，估算电压永远不能填入电芯/包压字段。 */
#define BB_PERIODIC_Q_FULL          0u
#define BB_PERIODIC_Q_PARTIAL       (1u << 6)
#define BB_PERIODIC_Q_CELL1_MISSING (1u << 7)
#define BB_PERIODIC_Q_CELL2_MISSING (1u << 8)
#define BB_PERIODIC_Q_CELL3_MISSING (1u << 9)
#define BB_PERIODIC_Q_PACK_MISSING  (1u << 10)
#define BB_PERIODIC_Q_SOC_ESTIMATED (1u << 11)
#define BB_PERIODIC_Q_SOC_INVALID   (1u << 12)
#define BB_PERIODIC_Q_CC_INVALID    (1u << 13) /* cc_raw 无本批可信转换 */
#define BB_PERIODIC_Q_TS1_INVALID   (1u << 14) /* TS1 无本批可信采样 */
#define BB_PERIODIC_Q_MISSING_MASK  (BB_PERIODIC_Q_CELL1_MISSING | \
                                     BB_PERIODIC_Q_CELL2_MISSING | \
                                     BB_PERIODIC_Q_CELL3_MISSING | \
                                     BB_PERIODIC_Q_PACK_MISSING)
#define BB_PERIODIC_Q_ALL           (BB_PERIODIC_Q_PARTIAL | \
                                     BB_PERIODIC_Q_MISSING_MASK | \
                                     BB_PERIODIC_Q_SOC_ESTIMATED | \
                                     BB_PERIODIC_Q_SOC_INVALID | \
                                     BB_PERIODIC_Q_CC_INVALID | \
                                     BB_PERIODIC_Q_TS1_INVALID)

/* 事件码（只用于 BB_KIND_EVENT，10 bit 范围）。 */
#define BB_EVENT_WAKE_CHARGER   0x10u
#define BB_EVENT_WAKE_MONITOR   0x11u
#define BB_EVENT_CAL_BEGIN      0x12u
#define BB_EVENT_CAL_END        0x13u
#define BB_EVENT_BQ_ADC_RESTART 0x15u
#define BB_EVENT_BQ_ADC_FAULT   0x16u
#define BB_EVENT_BQ_ADC_RECOVERED 0x17u
#define BB_EVENT_PROT_TRIP      0x18u
#define BB_EVENT_PROT_CLEARED   0x19u
#define BB_EVENT_PROT_CLEAR_FAILED 0x1Au
#define BB_EVENT_PROT_LATCHED   0x1Bu
#define BB_EVENT_PROT_SW_CHG_OCP 0x1Cu
#define BB_EVENT_PROT_SW_DSG_OCP 0x1Du
#define BB_EVENT_PROT_TEMP_INHIBIT 0x1Eu
#define BB_EVENT_PROT_TEMP_RECOVER 0x1Fu
#define BB_EVENT_BQ_VOLTAGE_ALARM 0x20u
#define BB_EVENT_BQ_VOLTAGE_CANCEL 0x21u
#define BB_EVENT_BQ_VOLTAGE_LATCHED 0x22u
#define BB_EVENT_BQ_VOLTAGE_MANUAL_CLEAR 0x23u
#define BB_EVENT_PROT_EARLY_SOC_CUTOFF 0x24u
#define BB_EVENT_PROT_EARLY_SOC_CLEARED 0x25u
#define BB_EVENT_PROT_CELL_UV 0x26u
#define BB_EVENT_PROT_CELL_UV_CLEARED 0x27u
#define BB_EVENT_PROT_CHARGE_FULL 0x28u
#define BB_EVENT_PROT_CHARGE_FULL_CLEARED 0x29u
#define BB_EVENT_PROT_CELL_OV 0x2Au
#define BB_EVENT_PROT_CELL_OV_CLEARED 0x2Bu

/* 旧记录的唤醒原因编码（flags 第 3–5 位）。 */
#define BB_WAKE_NONE        0u
#define BB_WAKE_RTC         1u
#define BB_WAKE_BUTTON      2u
#define BB_WAKE_BQ_ALERT    3u

#define BB_SHADOW_COUNT         12u  /* 最近 12 条记录的 RAM 影子 */

typedef struct
{
    uint32_t seq;
    uint32_t uptime_s;
    uint16_t cell_mv[3];
    uint16_t pack_mv;
    int16_t  cc_raw;
    uint16_t ts1_raw;
    uint16_t flags;
    uint8_t  kind;
    uint8_t  wake_mask;    /* 解码为 POWER_WAKE_* 位图 */
    uint16_t event_code;
    uint16_t quality_flags; /* BB_KIND_PERIODIC 的 BB_PERIODIC_Q_*；其它为 0 */
    uint8_t  valid;
} black_box_record_t;

/* RAM 影子：最近 12 条记录，只写 RAM，不擦写 Flash；Ozone 可直接展开。 */
typedef struct
{
    uint8_t count;
    black_box_record_t rec[BB_SHADOW_COUNT];  /* [0] 最新 */
} bb_shadow_t;

extern bb_shadow_t s_bb_shadow;

void BlackBox_Init(void);

/* 上电时头记录里的累计运行秒数（无有效头则为 0）。 */
uint32_t BlackBox_GetUptimeBase(void);

uint16_t BlackBox_GetHeadSlot(void);
uint32_t BlackBox_GetHeadSeq(void);

/* 读取头记录/指定槽；返回 0 成功，-1 参数/CRC/空白失败。 */
int BlackBox_ReadNewest(black_box_record_t *out);
int BlackBox_ReadSlot(uint16_t slot, black_box_record_t *out);

/* RAM 影子：上电时从 Flash 头记录向前加载最近 12 条；每次成功写记录
 * 前插更新。index 0 最新。LP 调试器连不上时，复位后在 NORM 读这里。 */
uint8_t BlackBox_GetShadowCount(void);
int BlackBox_ReadShadow(uint8_t index, black_box_record_t *out);

/* 返回 0 成功，-1 失败（失败同时置 sticky FAULT_FLASH_LOG）。
 * 记录只含电池快照 + 种类/唤醒原因；故障位图不入 Flash（24 B 布局已定）。 */
int BlackBox_WritePeriodic(uint32_t uptime_s);
/* LP 30 min 监测用：记录来自 HSI16 下捕获的 BQ 快照，而不是 BQ_GetSnapshot。
 * uptime_s 是累计 NORM 运行秒；RTC epoch 不能传到此处。 */
int BlackBox_WritePeriodicSnapshot(const bq_snapshot_t *snap, uint32_t uptime_s);

/* 显式按来源质量归档第九帧候选/部分采集；FULL 只允许 fresh+valid。
 * PARTIAL 要求至少一个 MISSING 位，并将每个缺失实测电压写 0；调用者
 * 负责确保非缺失项属于同批可信实测，CC/TS1 无效时须同时标出
 * BB_PERIODIC_Q_CC_INVALID/BB_PERIODIC_Q_TS1_INVALID 并把对应 raw 字段置 0。
 * 0=成功，-1=校验或 Flash 写失败。 */
int BlackBox_WritePeriodicQualified(const bq_snapshot_t *snap, uint32_t uptime_s,
                                    uint16_t quality_flags);
int BlackBox_WriteTransition(uint8_t transition_kind, uint8_t wake_cause,
                             uint32_t uptime_s);
int BlackBox_WriteWake(uint8_t power_wake_mask, uint32_t uptime_s);
int BlackBox_WriteEvent(uint16_t event_code, uint32_t uptime_s);

uint8_t BlackBox_HasError(void);

#endif /* APP_BLACK_BOX_H */
