ZZ8874-001/BMC_CMZY_080/(commit log)

2026-11-03 landmark:底层驱动跑通
    [Ozone_Watched_Data_1_261102.csv, decoder--261102-165521.csv, decoder--261102-170130.csv, decoder--261102-170455.csv, decoder--261102-172120.csv, decoder--261102-174121.csv, decoder--261102-182002.csv]
2026-11-04 fix:开机初始化电压异常 feat:M2a+b电压电流非法判断 feat:部分开关输出逻辑
    [Ozone_Watched_Data_1_261103.csv, Ozone_Watched_Data_1_261104.csv]
2026-11-05 fix:自检，电源，初始化若干杂碎问题 LP唤醒未修复，不稳定是LSE不稳定引起的
    [Ozone_Watched_Data_1_261105.csv]
2026-11-07 fix:低功耗模式嗅探和唤醒问题 唤醒依旧用的GPIO触发EXTI，但是没有总线干扰 嗅探走IWDG，虽然每次会复位RAM，但总比没有强
    [Ozone_Watched_Data_1_261106-mode2.csv, Ozone_Watched_Data_1_261106.csv, Ozone_Watched_Data_1_261107.csv, decoder--261102-165521.csv]
2026-11-10 unassigned:包压异常旁路逻辑 ADC抽象输出VC5和包压的事情已经很久了，尝试采取一些方式旁路这些输出让电池组至少能用但是明显过于复杂
    [Ozone_Watched_Data_1_261108.csv, Ozone_Watched_Data_1_261108_红灯时ok帧增长阶段.csv, Ozone_Watched_Data_1_261108_红灯时ok帧增长阶段后状态正常.csv, Ozone_Watched_Data_1_261108复位后.csv, Ozone_Watched_Data_1_261108复位完外加两次尝试失败后闪红灯前这次闪红灯后ok开始涨.csv, Ozone_Watched_Data_1_261108第一次重试后第二次重试前.csv, Ozone_Watched_Data_1_261108红灯快闪OK不涨.csv, Ozone_Watched_Data_1_261109.csv]
2026-11-10 fix:fuck烂掉的ADC，直接用正常的VC1，VC2值
    [Ozone_Watched_Data_1_261110.csv]
2026-11-11 fix:发现开关输出一整套操作有概率救回烂掉的ADC，遂加 feat:完善充电模式退出逻辑
2026-11-11 feat:放电负载稳定测试完善 feat:平衡充充电稳定测试完善
    [Ozone_Watched_Data_1_261111.csv]
2026-11-12 feat:完善基于电压和SOC的过冲-过放保护
    [Ozone_Watched_Data_1_261112-1.csv, Ozone_Watched_Data_1_261112.csv, soc_run1.csv, soc_runtestCHG.csv, soc_runtestDSG.csv]
2026-11-14 feat:充电电压异常保护旁路 更完善的BQADC复位操作
    [Ozone_Watched_Data_1_261113.csv, Ozone_Watched_Data_1_261114.csv]
2026-11-14 release: v0.0.11+hw0.80 版本嵌入与发布文档
    - 启动日志打印 HW0.80/SW0.0.11
    - 更新当前镜像尺寸与发布说明
    - 忽略本地 release/ 打包目录
